cnpem-emi/qds-cv-hw/README.md

# QDS-CV Hardware
Quench detection system for vertical cryostat.
