cnpem-emi/qds-cv-hw/mechanical/back-panel.dxf

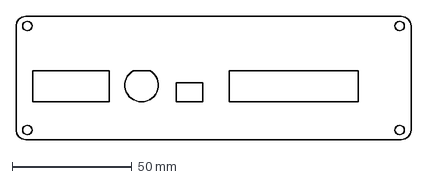
[picture p1: CAD file, 2023-08-09]
mechanical/back-panel.dxf
165.0 x 51.5 mm
