cnpem-emi/qds-cv-hw/pcb/cad/3dmodels/HAMMOND-1455T2202-body.stp

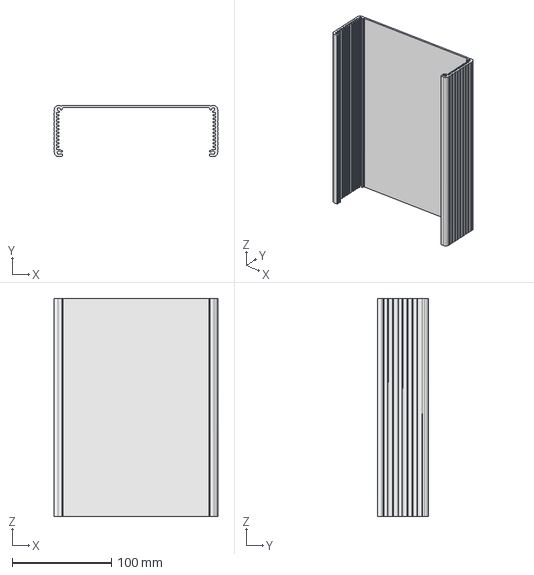
[picture p2: CAD file, 2023-05-24]
pcb/cad/3dmodels/HAMMOND-1455T2202-body.stp
165.0 x 51.5 x 220.0 mm
