cnpem-emi/qds-cv-hw/mechanical/front-panel.dxf

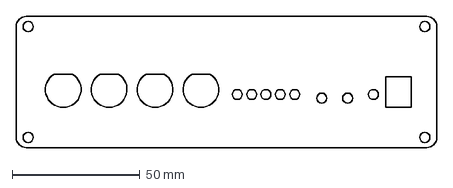
[picture p3: CAD file, 2023-08-09]
mechanical/front-panel.dxf
165.0 x 51.5 mm
