cnpem-emi/qds-cv-hw/pcb/cad/3dmodels/HAMMOND-1455T2202.stp

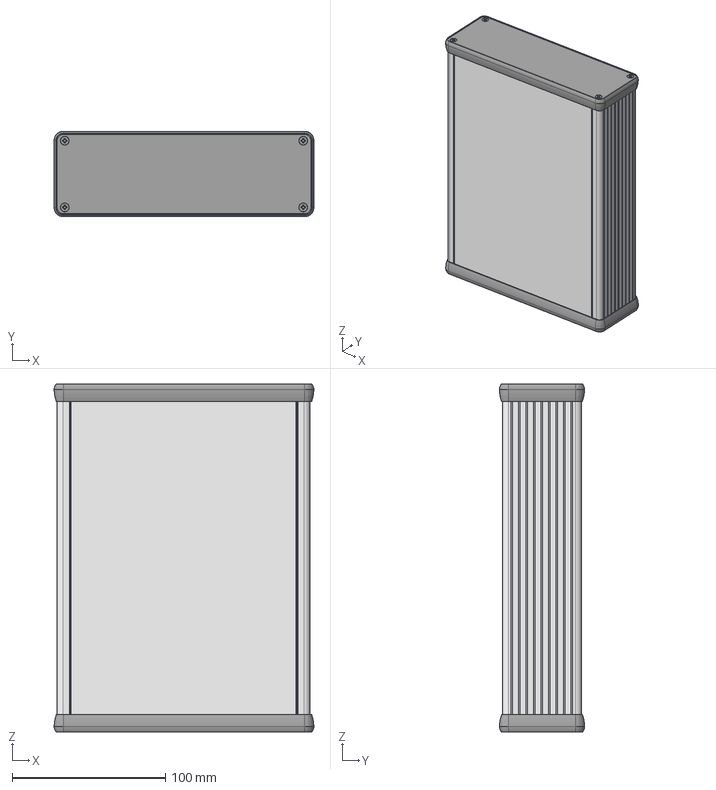
[picture p4: CAD file, 2023-05-24]
pcb/cad/3dmodels/HAMMOND-1455T2202.stp
169.5 x 55.7 x 227.0 mm
T extrusion 220mm
T Extrusion Cap 220mm
1455 Black Screw x 8
T Bezel closed x 2
