cnpem-emi/qds-cv-hw/pcb/cad/3dmodels/HAMMOND-1455T2202-top-plate.stp

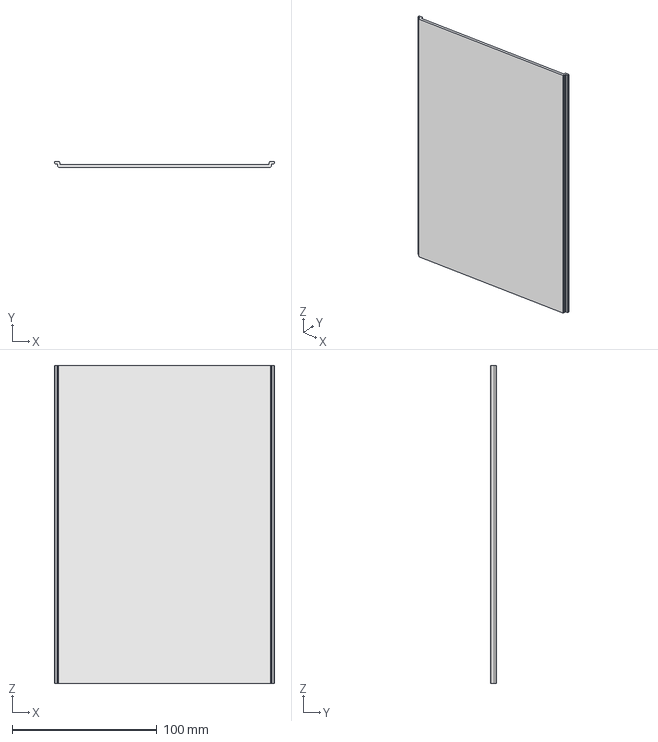
[picture p5: CAD file, 2023-05-24]
pcb/cad/3dmodels/HAMMOND-1455T2202-top-plate.stp
152.4 x 4.29 x 220.0 mm
