cnpem-emi/qds-cv-hw/pcb/cad/3dmodels/HAMMOND-1455T2202-end-panel.stp

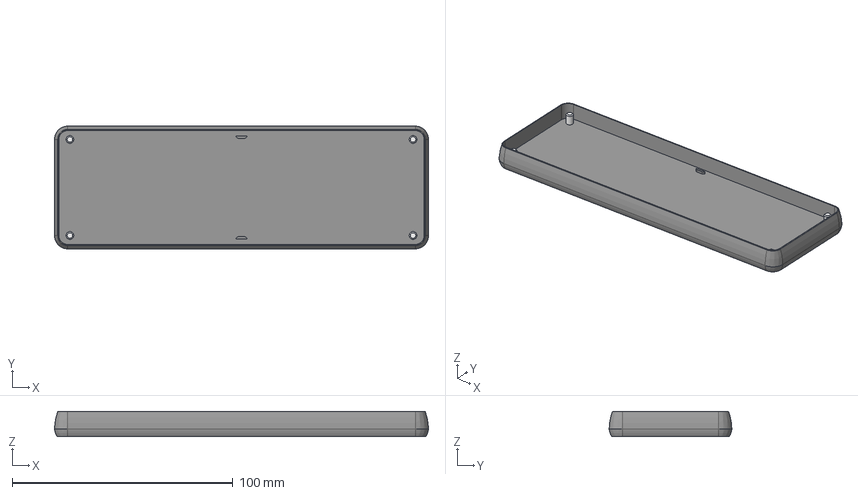
[picture p6: CAD file, 2023-05-24]
pcb/cad/3dmodels/HAMMOND-1455T2202-end-panel.stp
169.5 x 55.6 x 11.5 mm
_455T2202002
_455T2202003
_455T2202004
_455T2202005
_455T2202010
