cnpem-emi/qds-cv-hw/pcb/cad/3dmodels/D_SMA.step

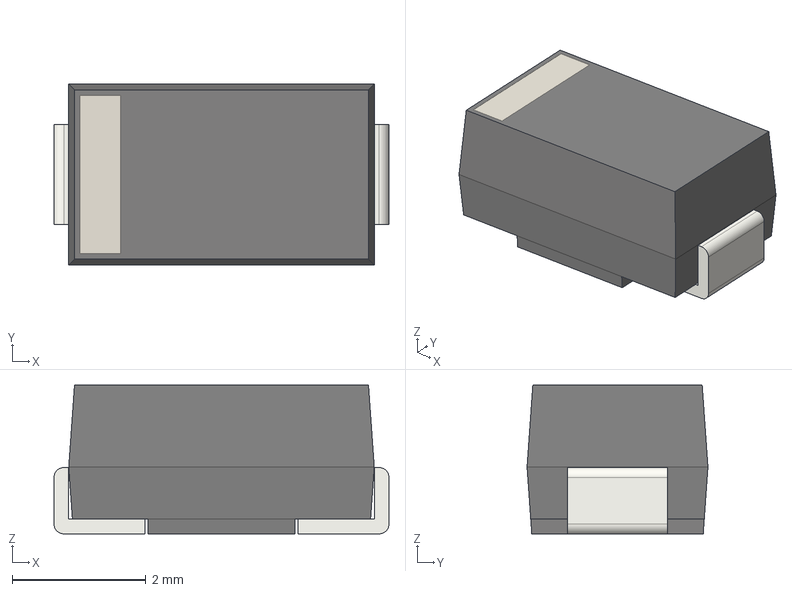
[picture p7: CAD file, 2023-05-23]
pcb/cad/3dmodels/D_SMA.step
5.00 x 2.70 x 2.22 mm
