cnpem-emi/qds-cv-hw/pcb/cad/3dmodels/D_SOD-323.step

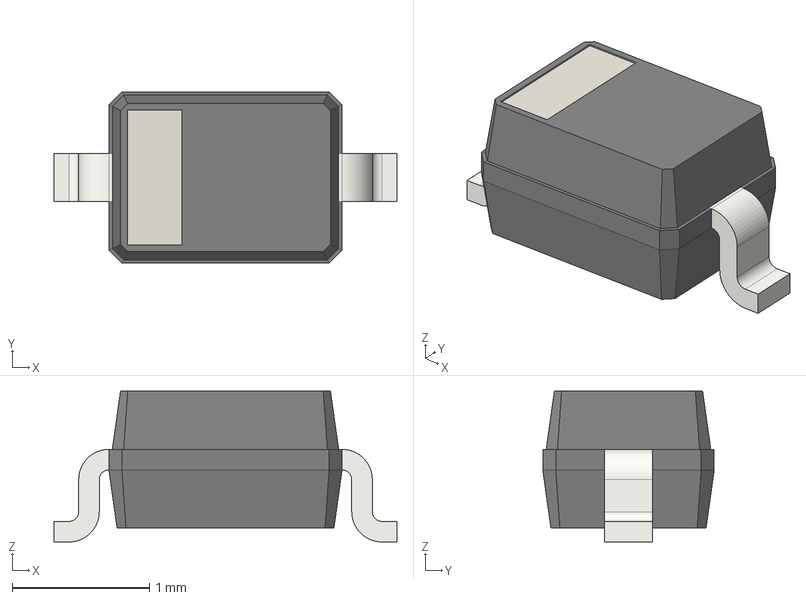
[picture p8: CAD file, 2023-05-23]
pcb/cad/3dmodels/D_SOD-323.step
2.50 x 1.25 x 1.10 mm
