cnpem-emi/qds-cv-hw/pcb/cad/3dmodels/Relay_DPDT_Finder_30.22.step

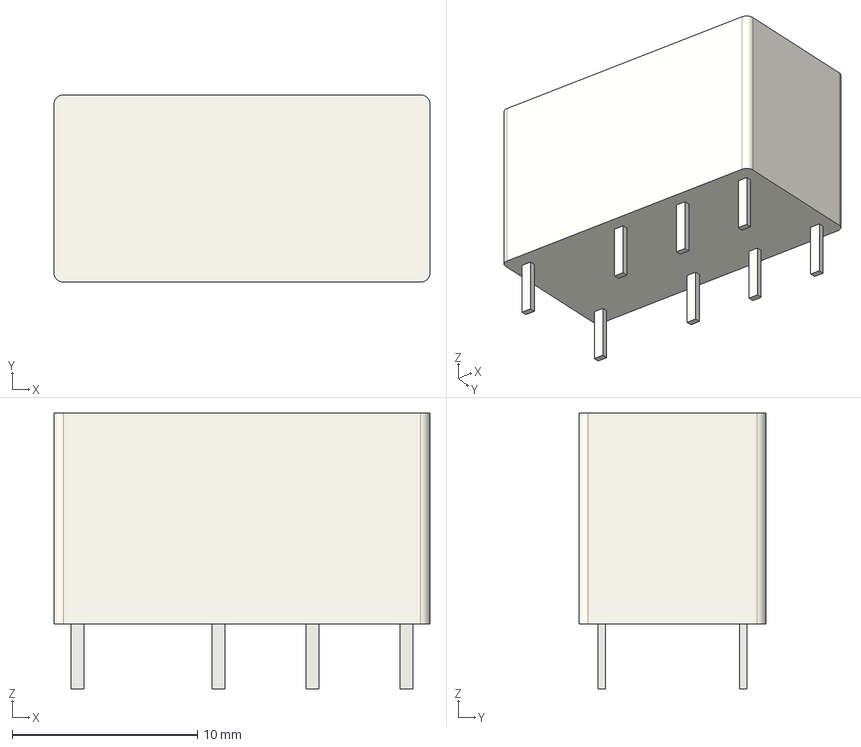
[picture p9: CAD file, 2023-05-23]
pcb/cad/3dmodels/Relay_DPDT_Finder_30.22.step
20.3 x 10.1 x 14.9 mm
