cnpem-emi/qds-cv-hw/pcb/cad/3dmodels/Converter_DCDC_RECOM_R-78E-0.5_THT.step

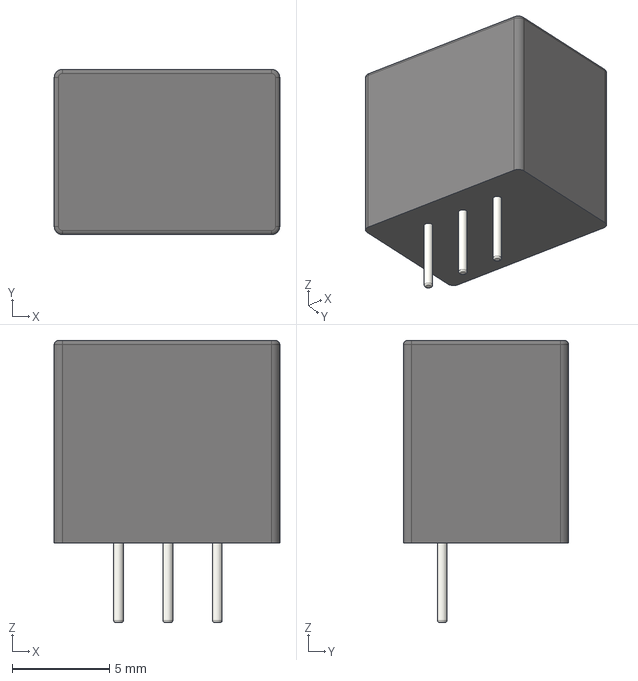
[picture p11: CAD file, 2023-05-23]
pcb/cad/3dmodels/Converter_DCDC_RECOM_R-78E-0.5_THT.step
11.6 x 8.50 x 14.5 mm
