cnpem-emi/qds-cv-hw/pcb/cad/3dmodels/SOT-23-6.step

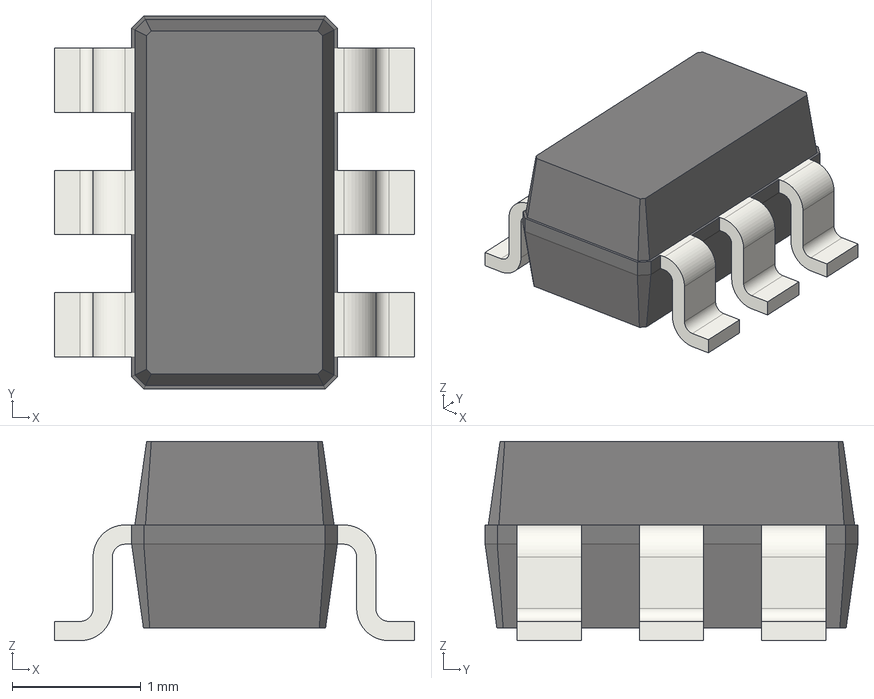
[picture p12: CAD file, 2023-05-23]
pcb/cad/3dmodels/SOT-23-6.step
2.80 x 2.90 x 1.55 mm
