cnpem-emi/qds-cv-hw/pcb/cad/3dmodels/C_Elec_6.3x7.7.step

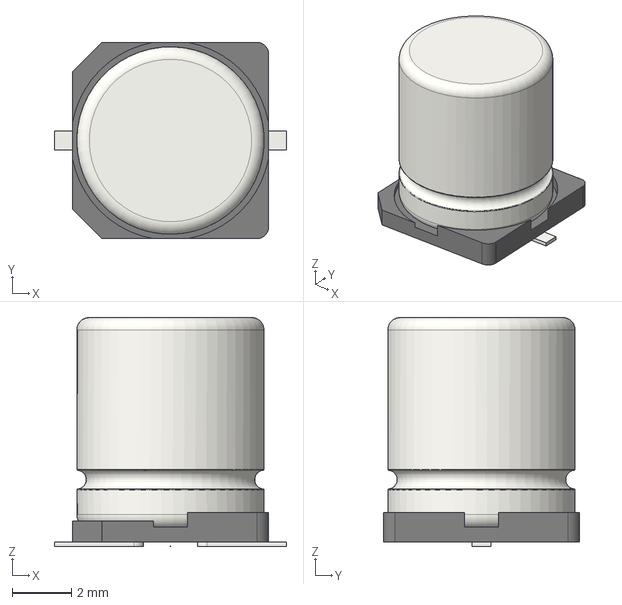
[picture p13: CAD file, 2023-05-23]
pcb/cad/3dmodels/C_Elec_6.3x7.7.step
7.80 x 6.60 x 7.70 mm
