cnpem-emi/qds-cv-hw/pcb/cad/3dmodels/CP_EIA-3528-21_Kemet-B.step

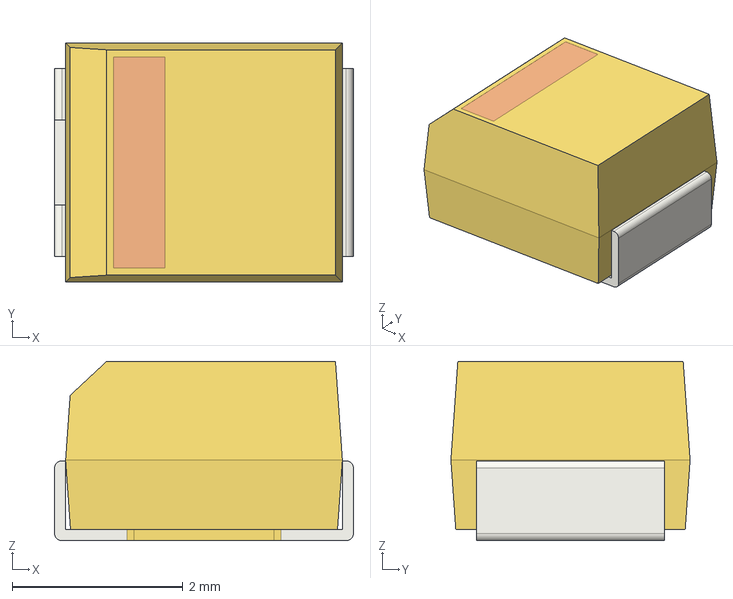
[picture p14: CAD file, 2023-05-23]
pcb/cad/3dmodels/CP_EIA-3528-21_Kemet-B.step
3.50 x 2.80 x 2.10 mm
