cnpem-emi/qds-cv-hw/pcb/cad/3dmodels/C_1206_3216Metric.step

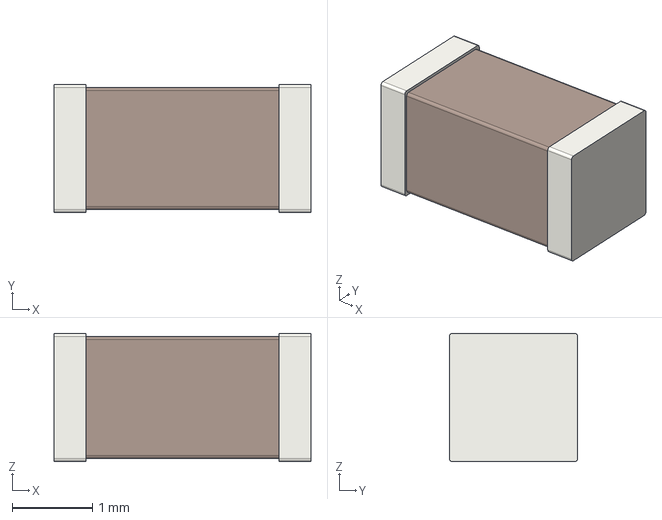
[picture p15: CAD file, 2023-05-23]
pcb/cad/3dmodels/C_1206_3216Metric.step
3.20 x 1.60 x 1.60 mm
