cnpem-emi/qds-cv-hw/pcb/cad/3dmodels/SO-14_3.9x8.65mm_P1.27mm.step

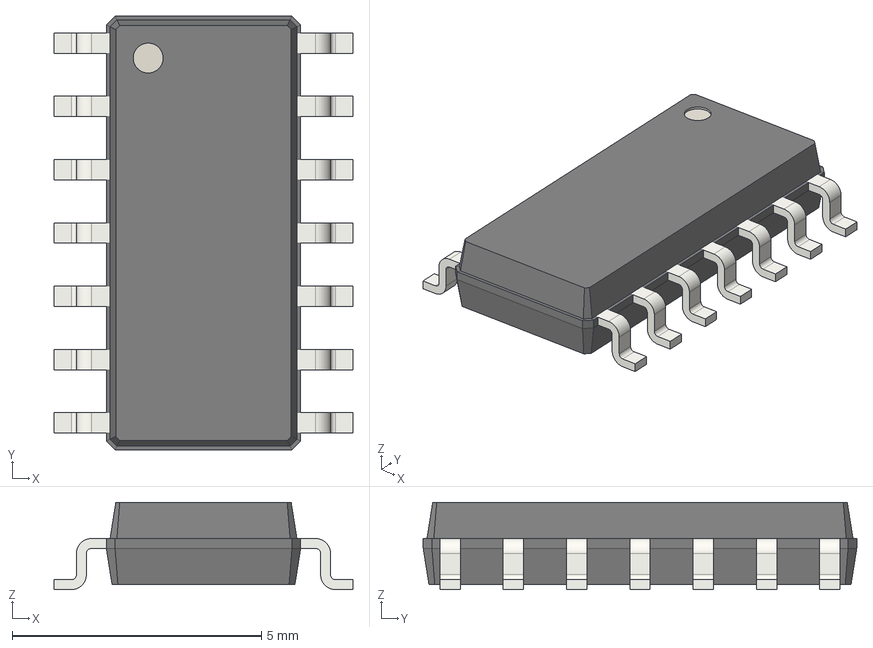
[picture p16: CAD file, 2023-05-23]
pcb/cad/3dmodels/SO-14_3.9x8.65mm_P1.27mm.step
6.00 x 8.70 x 1.75 mm
