cnpem-emi/qds-cv-hw/pcb/cad/3dmodels/SOT-223.step

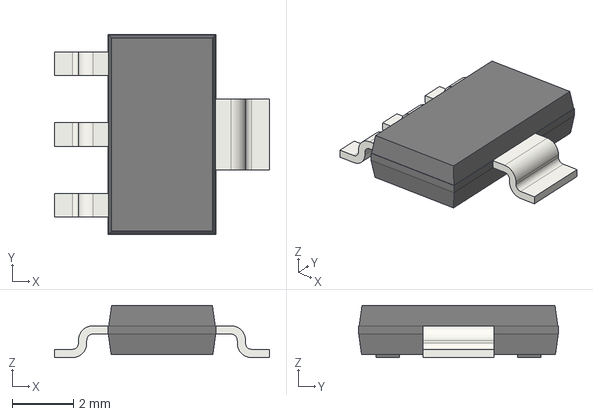
[picture p17: CAD file, 2023-05-23]
pcb/cad/3dmodels/SOT-223.step
7.00 x 6.50 x 1.70 mm
