cnpem-emi/qds-cv-hw/pcb/cad/3dmodels/R_0805_2012Metric.step

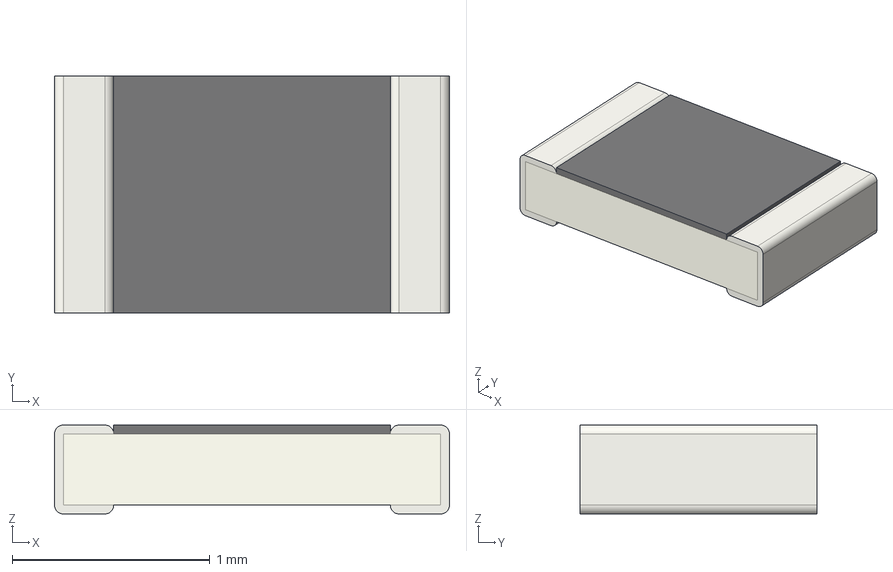
[picture p18: CAD file, 2023-05-23]
pcb/cad/3dmodels/R_0805_2012Metric.step
2.00 x 1.20 x 0.45 mm
