cnpem-emi/qds-cv-hw/pcb/cad/3dmodels/SW_DIP_SPSTx01_Slide_9.78x4.72mm_W7.62mm_P2.54mm.step

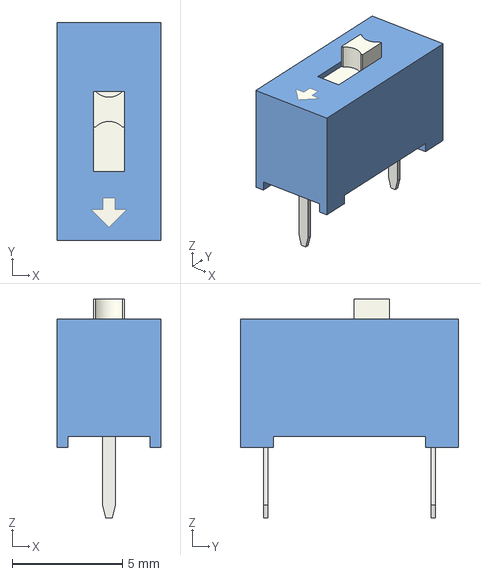
[picture p20: CAD file, 2023-05-23]
pcb/cad/3dmodels/SW_DIP_SPSTx01_Slide_9.78x4.72mm_W7.62mm_P2.54mm.step
4.72 x 9.90 x 9.95 mm
