cnpem-emi/qds-cv-hw/pcb/cad/3dmodels/C_0805_2012Metric.step

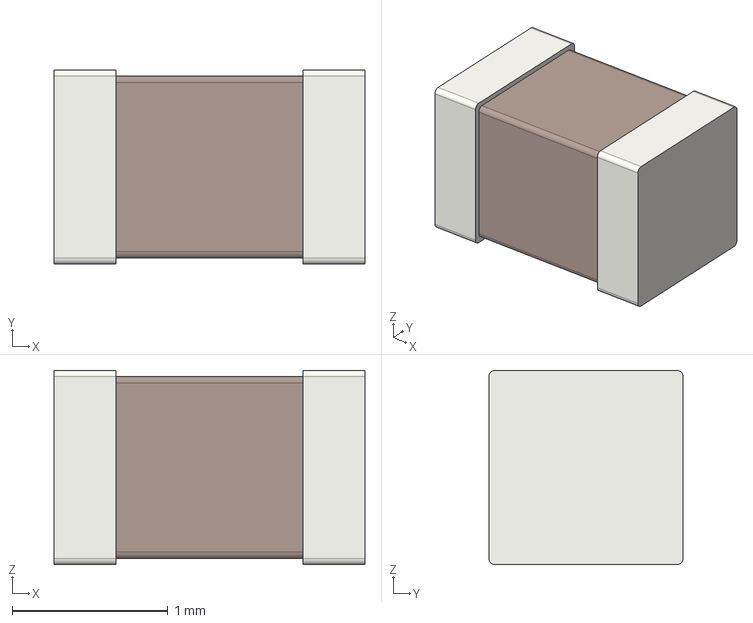
[picture p21: CAD file, 2023-05-23]
pcb/cad/3dmodels/C_0805_2012Metric.step
2.00 x 1.25 x 1.25 mm
