cnpem-emi/qds-cv-hw/pcb/cad/3dmodels/C_0603_1608Metric.step

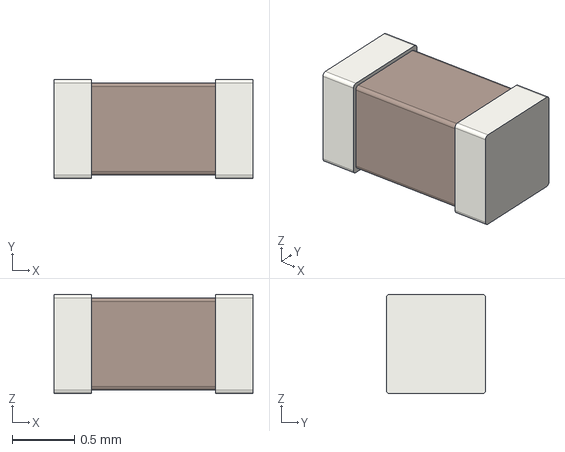
[picture p22: CAD file, 2023-05-23]
pcb/cad/3dmodels/C_0603_1608Metric.step
1.60 x 0.8 x 0.8 mm
