cnpem-emi/qds-cv-hw/pcb/cad/3dmodels/SO-20_12.8x7.5mm_P1.27mm.step

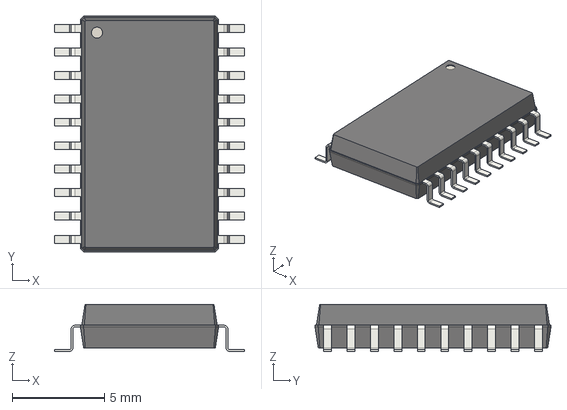
[picture p23: CAD file, 2023-05-23]
pcb/cad/3dmodels/SO-20_12.8x7.5mm_P1.27mm.step
10.3 x 12.8 x 2.55 mm
