cnpem-emi/qds-cv-hw/pcb/cad/3dmodels/SOIC-16_3.9x9.9mm_P1.27mm.step

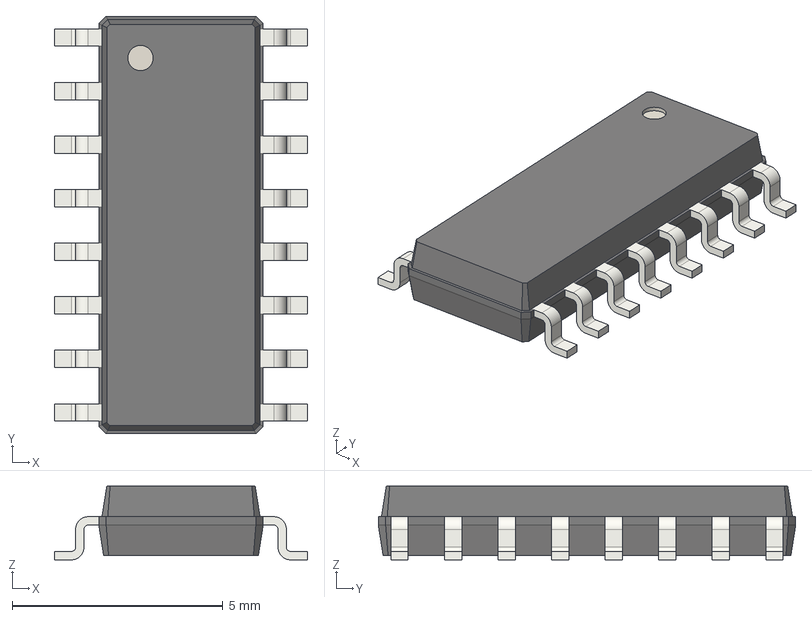
[picture p24: CAD file, 2023-05-23]
pcb/cad/3dmodels/SOIC-16_3.9x9.9mm_P1.27mm.step
6.00 x 9.90 x 1.75 mm
