cnpem-emi/qds-cv-hw/pcb/cad/3dmodels/SW_DIP_SPSTx04_Slide_6.7x11.72mm_W8.61mm_P2.54mm_LowProfile.step

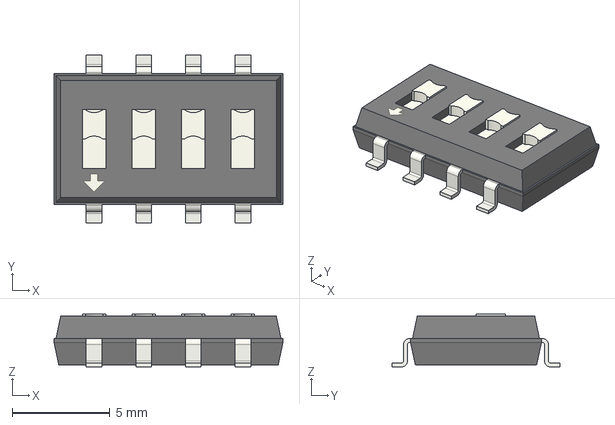
[picture p25: CAD file, 2023-05-23]
pcb/cad/3dmodels/SW_DIP_SPSTx04_Slide_6.7x11.72mm_W8.61mm_P2.54mm_LowProfile.step
11.7 x 8.61 x 2.70 mm
