cnpem-emi/qds-cv-hw/pcb/cad/3dmodels/SOIC-8_3.9x4.9mm_P1.27mm.step

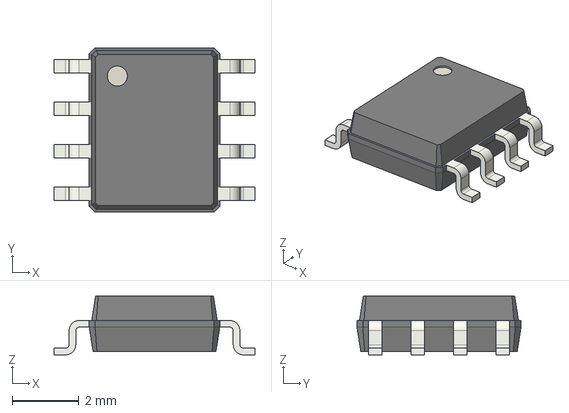
[picture p26: CAD file, 2023-05-23]
pcb/cad/3dmodels/SOIC-8_3.9x4.9mm_P1.27mm.step
6.00 x 4.90 x 1.75 mm
