cnpem-emi/qds-cv-hw/pcb/cad/3dmodels/SOT-23.step

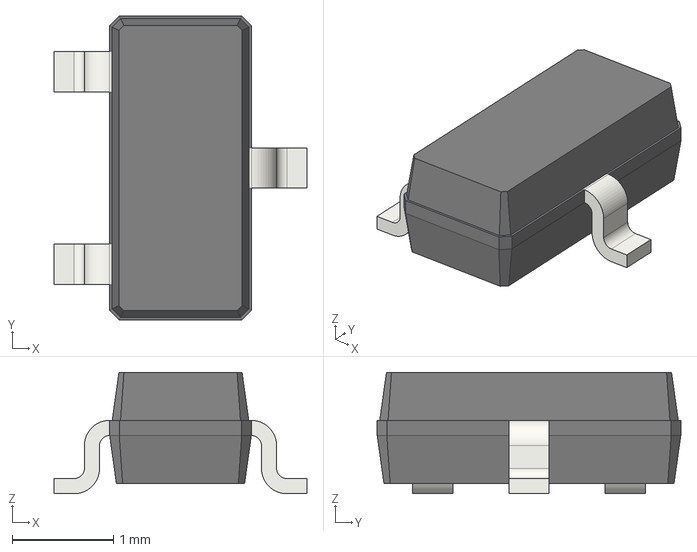
[picture p27: CAD file, 2023-05-23]
pcb/cad/3dmodels/SOT-23.step
2.50 x 3.00 x 1.20 mm
