cnpem-emi/qds-cv-hw/pcb/cad/3dmodels/C_1812_4532Metric.step

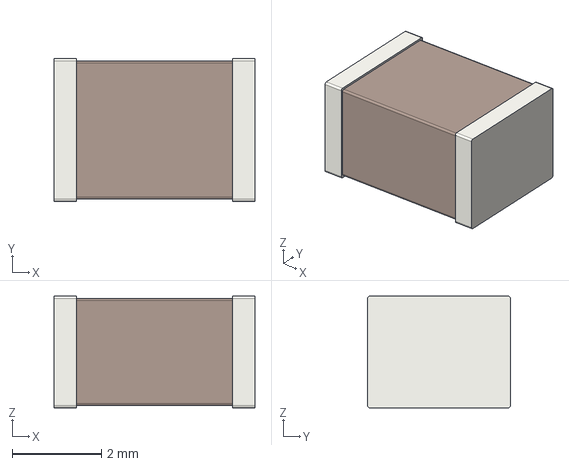
[picture p28: CAD file, 2023-05-23]
pcb/cad/3dmodels/C_1812_4532Metric.step
4.50 x 3.20 x 2.50 mm
