cnpem-emi/qds-cv-hw/pcb/cad/3dmodels/DUB0008A.stp

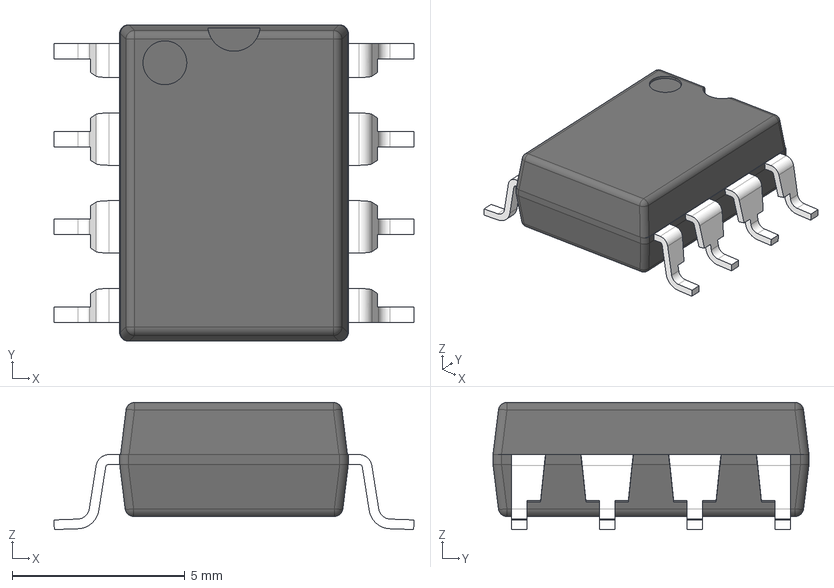
[picture p29: CAD file, 2023-05-23]
pcb/cad/3dmodels/DUB0008A.stp
10.4 x 9.15 x 3.68 mm
BODY-SO_AF0
LEAD-SO_AF1
LEAD-SO x 4
LEAD-SO_AF0
LEAD-SO_AF3
LEAD-SO_AF2
