cnpem-emi/qds-cv-hw/pcb/cad/3dmodels/CP_EIA-6032-28_Kemet-C.step

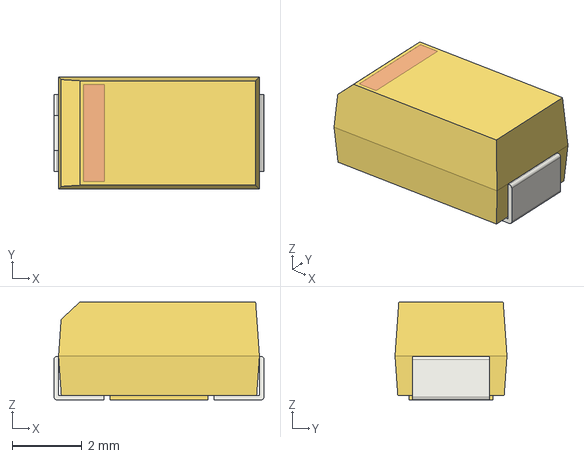
[picture p30: CAD file, 2023-05-23]
pcb/cad/3dmodels/CP_EIA-6032-28_Kemet-C.step
6.00 x 3.20 x 2.80 mm
