cnpem-emi/qds-cv-hw/pcb/cad/3dmodels/SW_Tactile_SPST_Angled_PTS645Vx39-2LFS.step

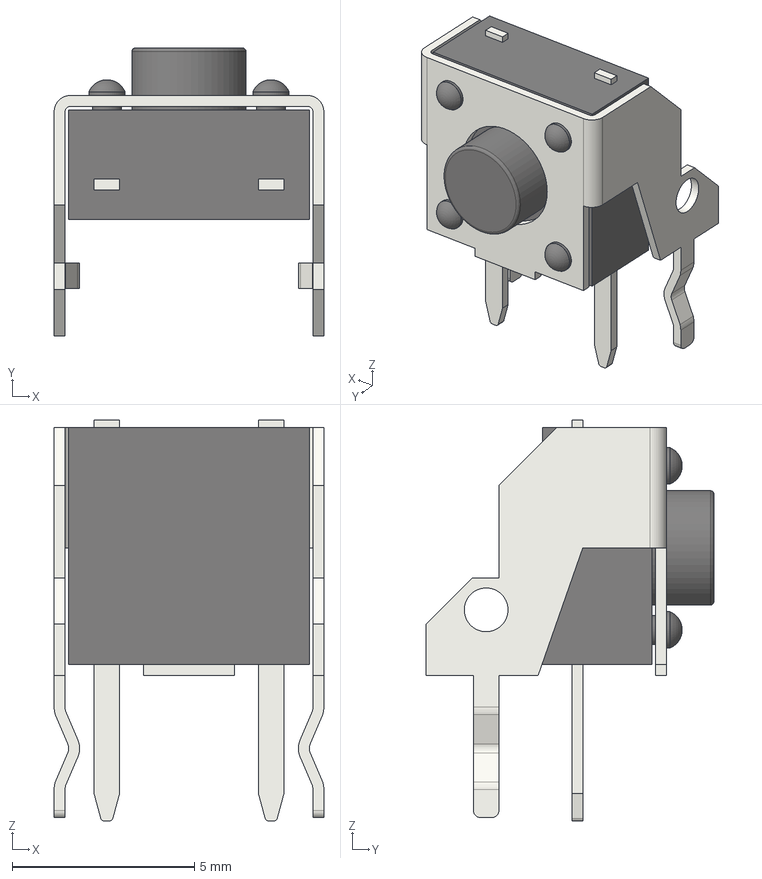
[picture p31: CAD file, 2023-05-23]
pcb/cad/3dmodels/SW_Tactile_SPST_Angled_PTS645Vx39-2LFS.step
7.40 x 7.90 x 11.0 mm
