cnpem-emi/qds-cv-hw/pcb/cad/3dmodels/DSUB-25_Female_Horizontal_P2.77x2.84mm_EdgePinOffset7.70mm_Housed_MountingHolesOffset9.12mm.step

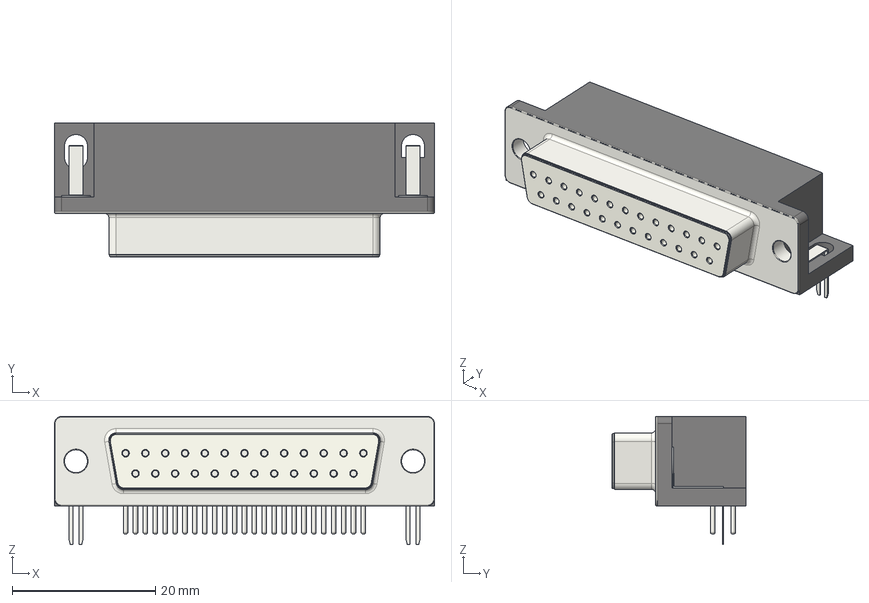
[picture p32: CAD file, 2023-05-23]
pcb/cad/3dmodels/DSUB-25_Female_Horizontal_P2.77x2.84mm_EdgePinOffset7.70mm_Housed_MountingHolesOffset9.12mm.step
53.1 x 18.7 x 17.9 mm
