cnpem-emi/qds-cv-hw/pcb/cad/3dmodels/D_SMB.step

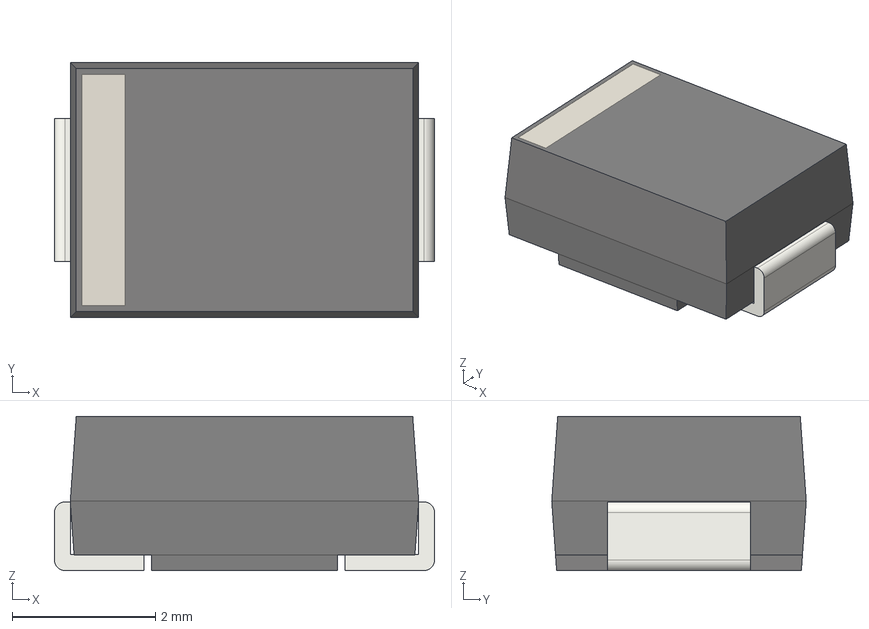
[picture p33: CAD file, 2023-05-23]
pcb/cad/3dmodels/D_SMB.step
5.30 x 3.55 x 2.15 mm
