cnpem-emi/qds-cv-hw/pcb/cad/3dmodels/SOP-8_6.62x9.15mm_P2.54mm.stp

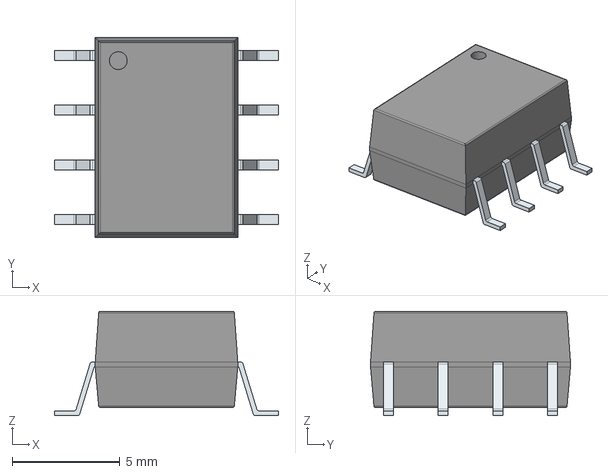
[picture p34: CAD file, 2023-05-23]
pcb/cad/3dmodels/SOP-8_6.62x9.15mm_P2.54mm.stp
10.4 x 9.29 x 4.85 mm
PinsArrayLR
