cnpem-emi/qds-cv-hw/pcb/cad/3dmodels/ZH212.step

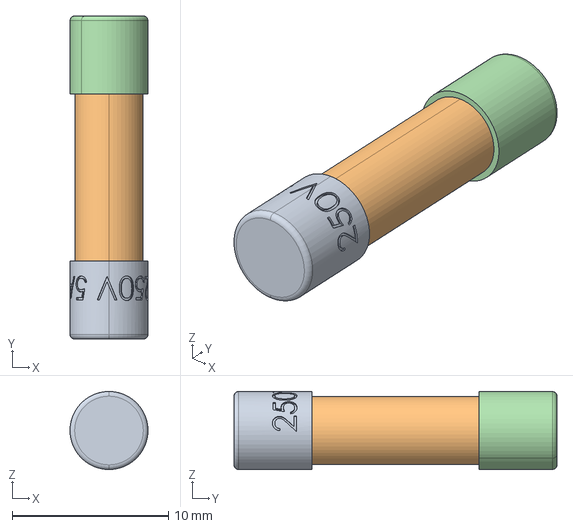
[picture p35: CAD file, 2023-05-16]
pcb/cad/3dmodels/ZH212.step
5.00 x 20.7 x 5.00 mm
