cnpem-emi/qds-cv-hw/pcb/cad/3dmodels/TEST-POINT-White-Keystone-5012.stp

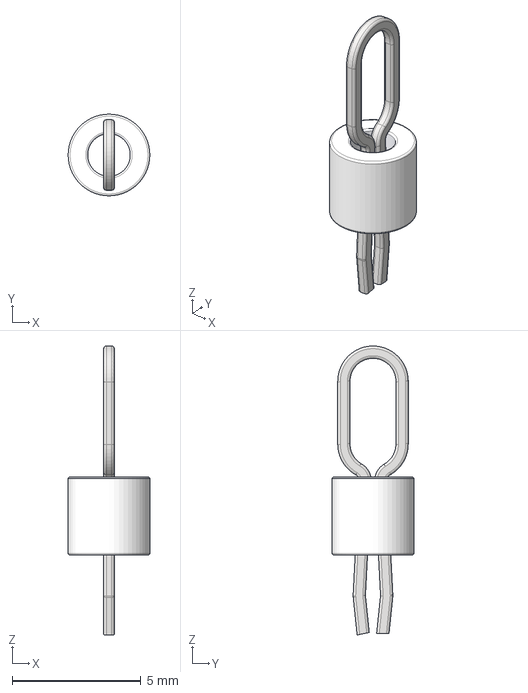
[picture p36: CAD file, 2023-05-16]
pcb/cad/3dmodels/TEST-POINT-White-Keystone-5012.stp
3.17 x 3.17 x 11.2 mm
