cnpem-emi/qds-cv-hw/pcb/cad/3dmodels/BNC5-P-C-HN-ST-CA1.stp

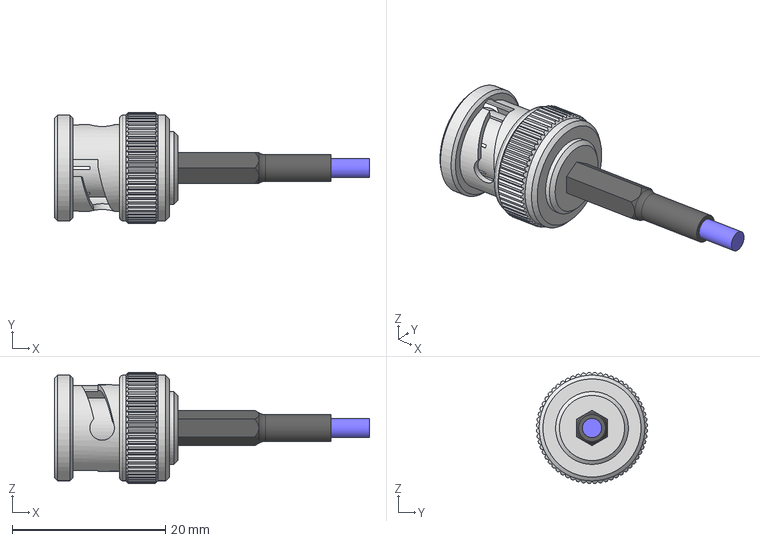
[picture p37: CAD file, 2023-05-04]
pcb/cad/3dmodels/BNC5-P-C-HN-ST-CA1.stp
41.1 x 14.5 x 14.5 mm
BNC5-P-C-XX-ST-CA1_PIN
BNC5-P-C-XX-ST-CA1_BODY
