cnpem-emi/qds-cv-hw/pcb/cad/3dmodels/DB-9-s8655mh0901bxx.STP

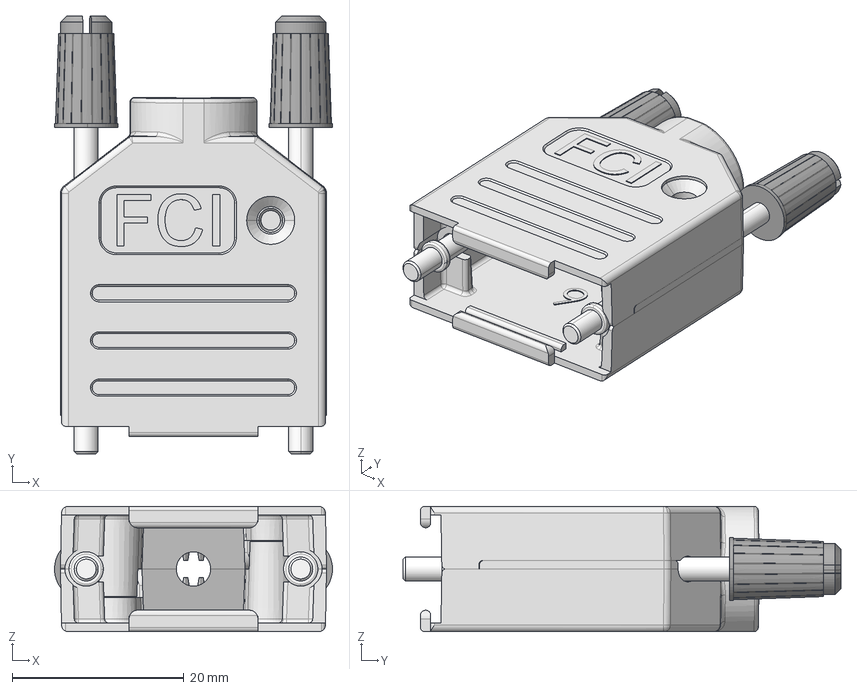
[picture p38: CAD file, 2023-05-04]
pcb/cad/3dmodels/DB-9-s8655mh0901bxx.STP
32.4 x 51.0 x 14.6 mm
DTZK9-FCI-D5 x 2
MFX-M3X10_MFX x 2
4_ED5 x 2
D-JS x 2
KNOP_TIL_JACK_SCREW x 2
