cnpem-emi/qds-cv-hw/pcb/cad/3dmodels/MSOP-12_MSE.STEP

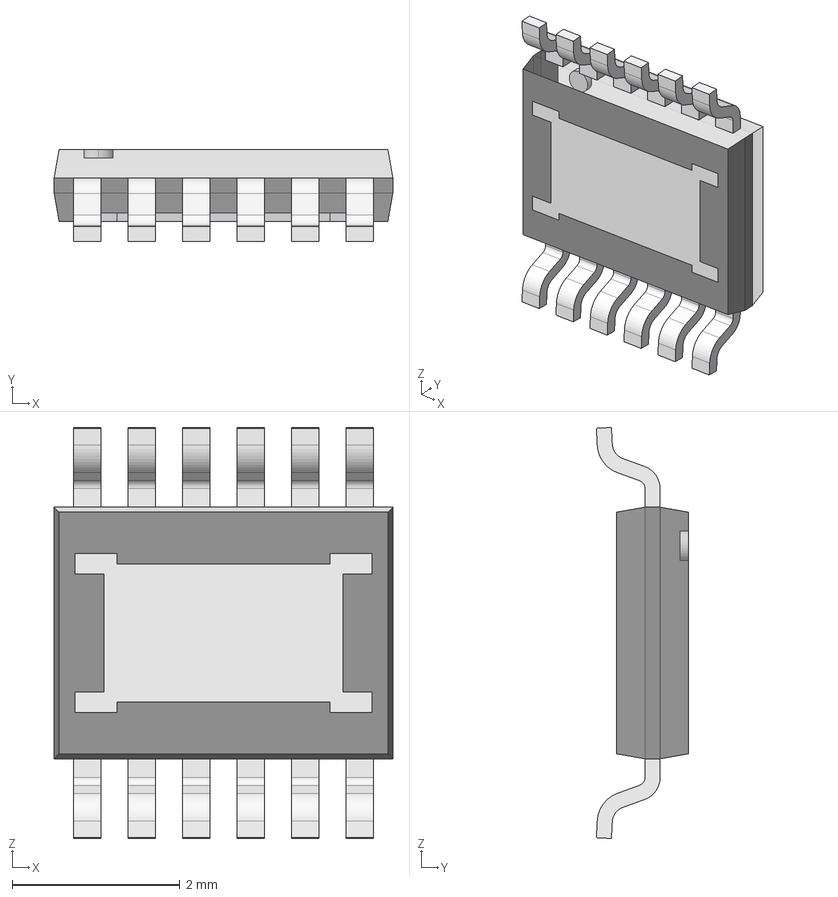
[picture p39: CAD file, 2023-04-27]
pcb/cad/3dmodels/MSOP-12_MSE.STEP
4.04 x 1.10 x 4.90 mm
