cnpem-emi/qds-cv-hw/pcb/cad/3dmodels/JCM30.STEP

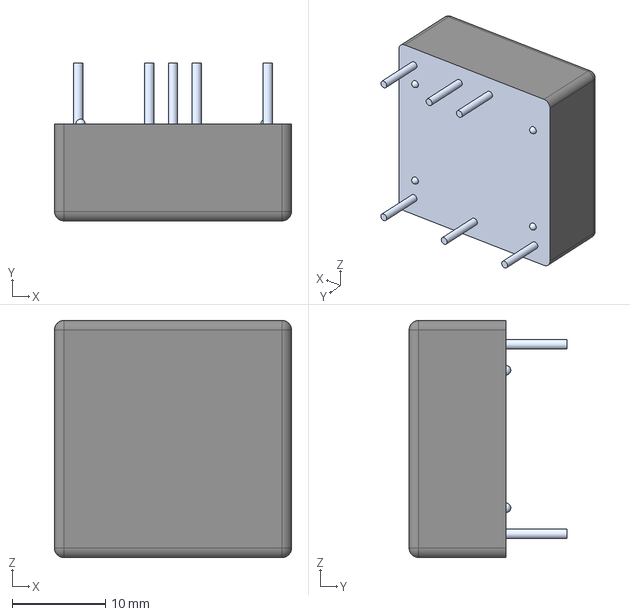
[picture p40: CAD file, 2023-04-27]
pcb/cad/3dmodels/JCM30.STEP
25.4 x 16.9 x 25.4 mm
