cnpem-emi/qds-cv-hw/pcb/cad/3dmodels/3224X.stp

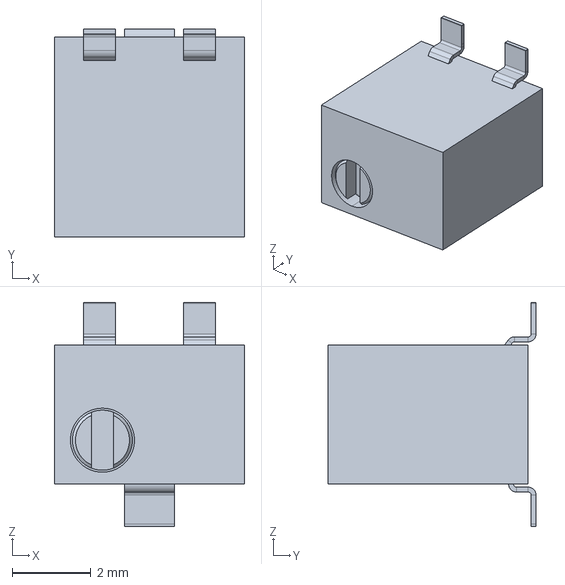
[picture p41: CAD file, 2023-04-01]
pcb/cad/3dmodels/3224X.stp
4.83 x 5.28 x 5.68 mm
