cnpem-emi/qds-cv-hw/pcb/cad/3dmodels/934CB_ID.STEP

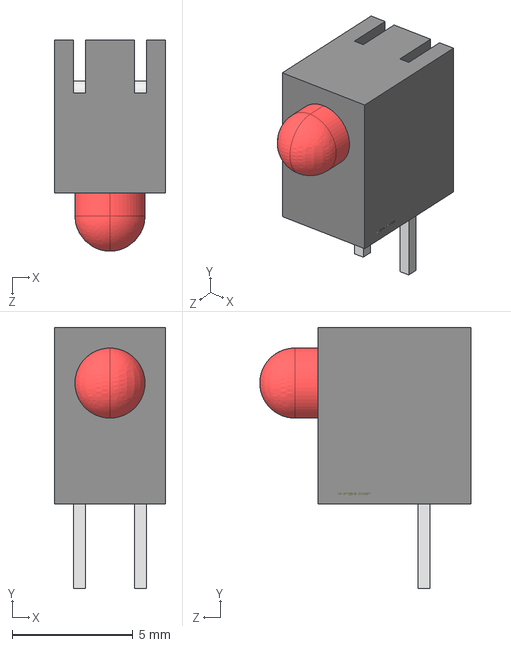
[picture p42: CAD file, 2023-03-22]
pcb/cad/3dmodels/934CB_ID.STEP
4.60 x 10.8 x 8.75 mm
