cnpem-emi/qds-cv-hw/pcb/cad/3dmodels/ZH242.STEP

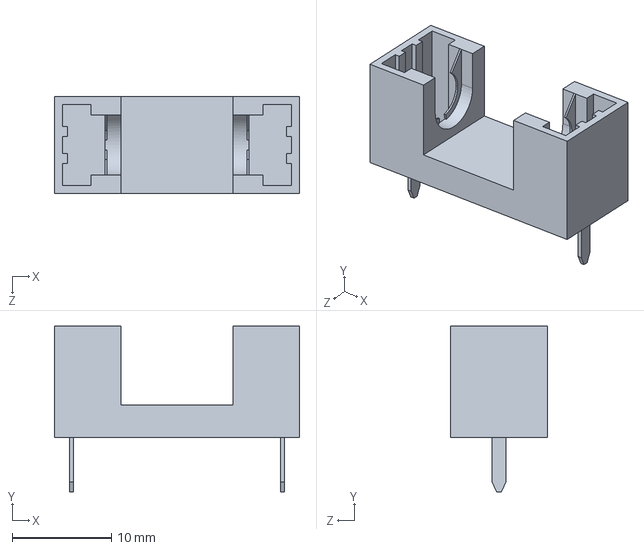
[picture p43: CAD file, 2023-03-21]
pcb/cad/3dmodels/ZH242.STEP
24.7 x 16.7 x 9.75 mm
