cnpem-emi/qds-cv-hw/pcb/cad/3dmodels/SMBJ15A.step

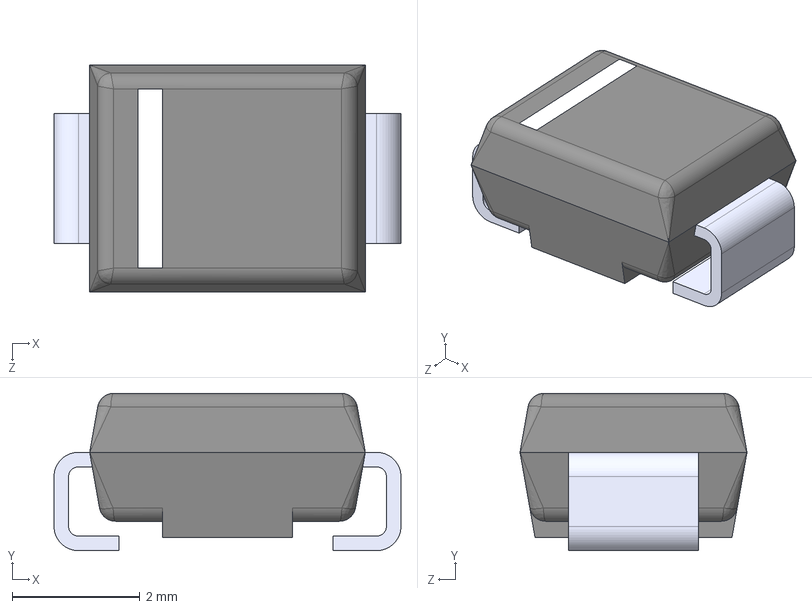
[picture p44: CAD file, 2023-03-21]
pcb/cad/3dmodels/SMBJ15A.step
5.44 x 2.46 x 3.56 mm
