cnpem-emi/qds-cv-hw/pcb/cad/3dmodels/LT1965EMS8E_PBF.step

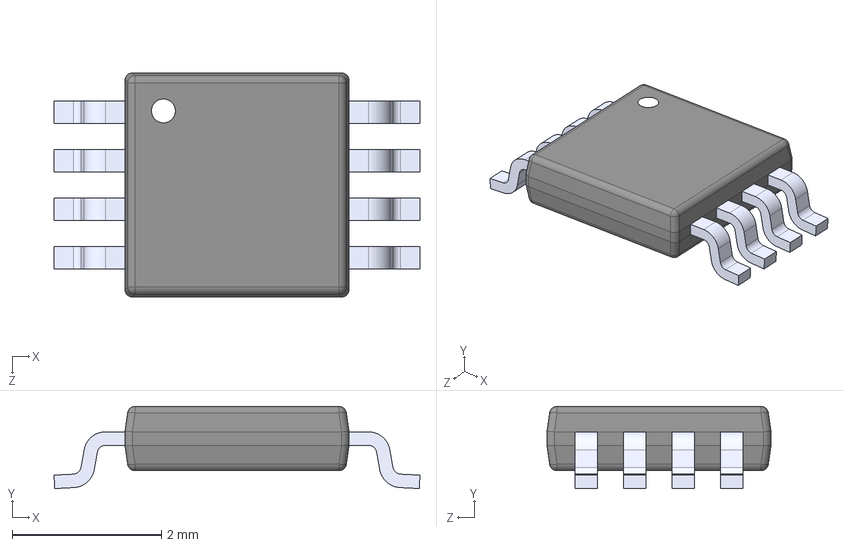
[picture p45: CAD file, 2023-03-21]
pcb/cad/3dmodels/LT1965EMS8E_PBF.step
4.90 x 1.10 x 3.00 mm
