cnpem-emi/qds-cv-hw/pcb/cad/3dmodels/CUI_DEVICES_PJ-002AH.step

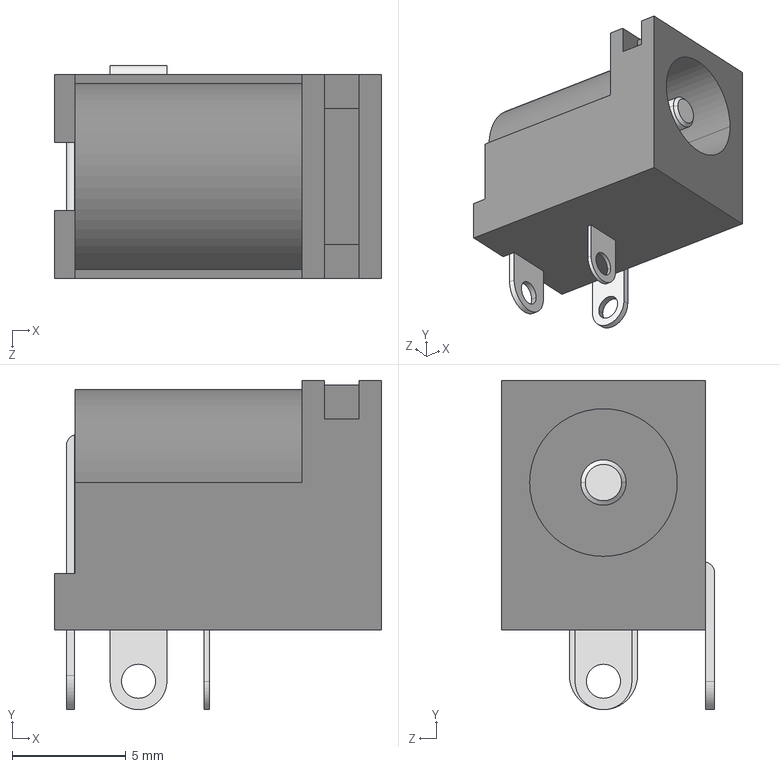
[picture p46: CAD file, 2023-03-21]
pcb/cad/3dmodels/CUI_DEVICES_PJ-002AH.step
14.4 x 14.5 x 9.40 mm
