cnpem-emi/qds-cv-hw/pcb/cad/3dmodels/ZH242-CAP.STEP

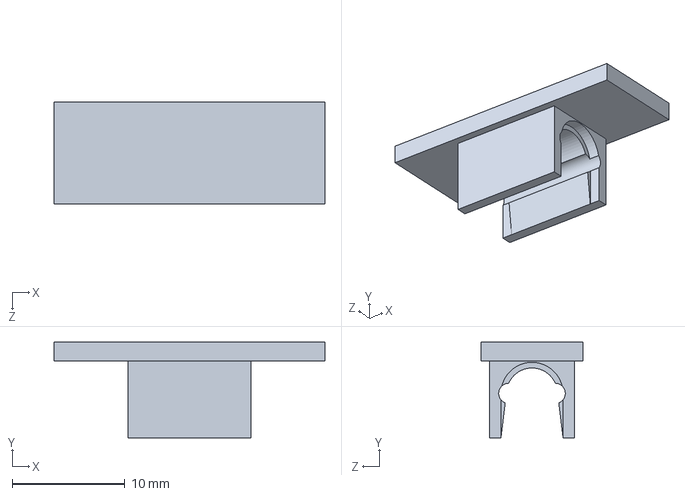
[picture p47: CAD file, 2023-03-21]
pcb/cad/3dmodels/ZH242-CAP.STEP
24.0 x 8.50 x 9.00 mm
