cnpem-emi/qds-cv-hw/pcb/cad/3dmodels/RI-1515S.step

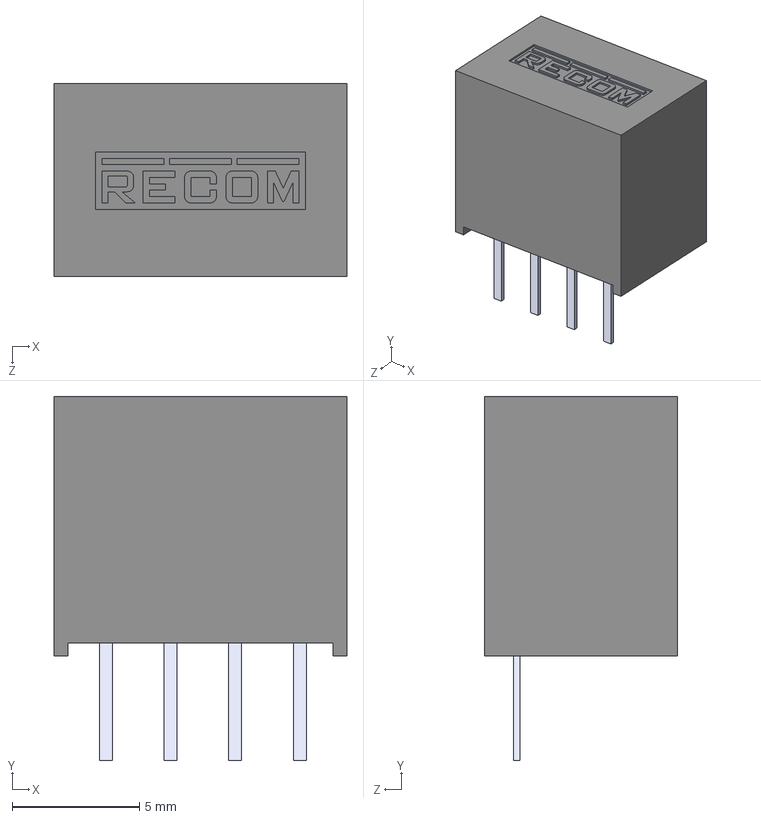
[picture p48: CAD file, 2023-03-20]
pcb/cad/3dmodels/RI-1515S.step
11.5 x 14.3 x 7.60 mm
