cnpem-emi/qds-cv-hw/pcb/cad/3dmodels/HFBR-1521Z.STEP

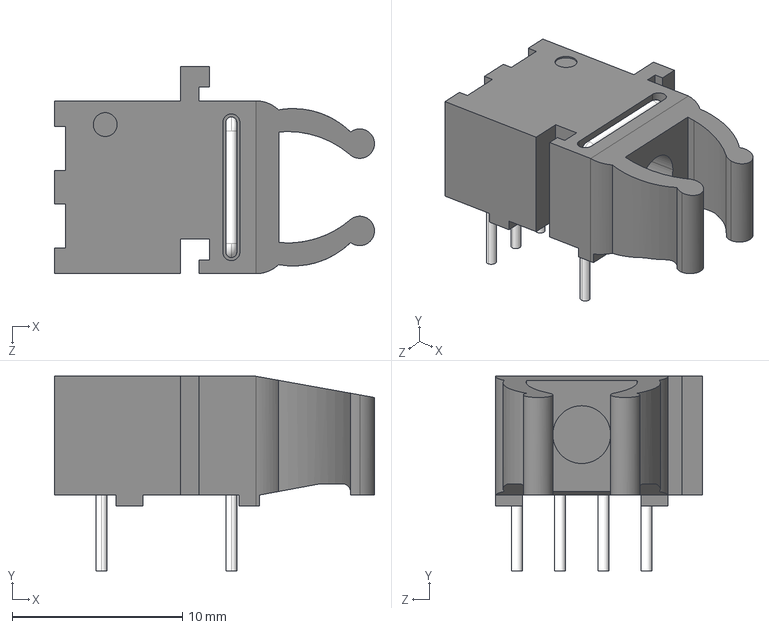
[picture p49: CAD file, 2023-03-20]
pcb/cad/3dmodels/HFBR-1521Z.STEP
18.8 x 11.4 x 12.2 mm
