cnpem-emi/qds-cv-hw/(list of files, cad)

Other CAD files:
pcb/cad/3dmodels/934CB_GD.STEP
pcb/cad/3dmodels/0731375003.STEP
