cnpem-emi/qds-cv-hw/simulation/validation-vsource-50ms.txt

0 5
+10m 5
+1u 0
+10m 0

+1u 5
+50m 5
+1u 0
+5m 0

+1u 5
+5m 5
+1u 0
+5m 0

+1u 5
+50m 5
+1u 0
+70m 0

+1u 5
