cnpem-emi/qds-cv-hw/simulation/validation-vsource-micro.txt

+1n 5
+1u 5
+1n 0
+1u 0

+1n 5
+2u 5
+1n 0
+1u 0

+1n 5
+1u 5
+1n 0
+1u 0

+1n 5
+2u 5
+1n 0
+1u 0
