cnpem-emi/qds-cv-hw/pcb/pdf/qds-cv.pdf

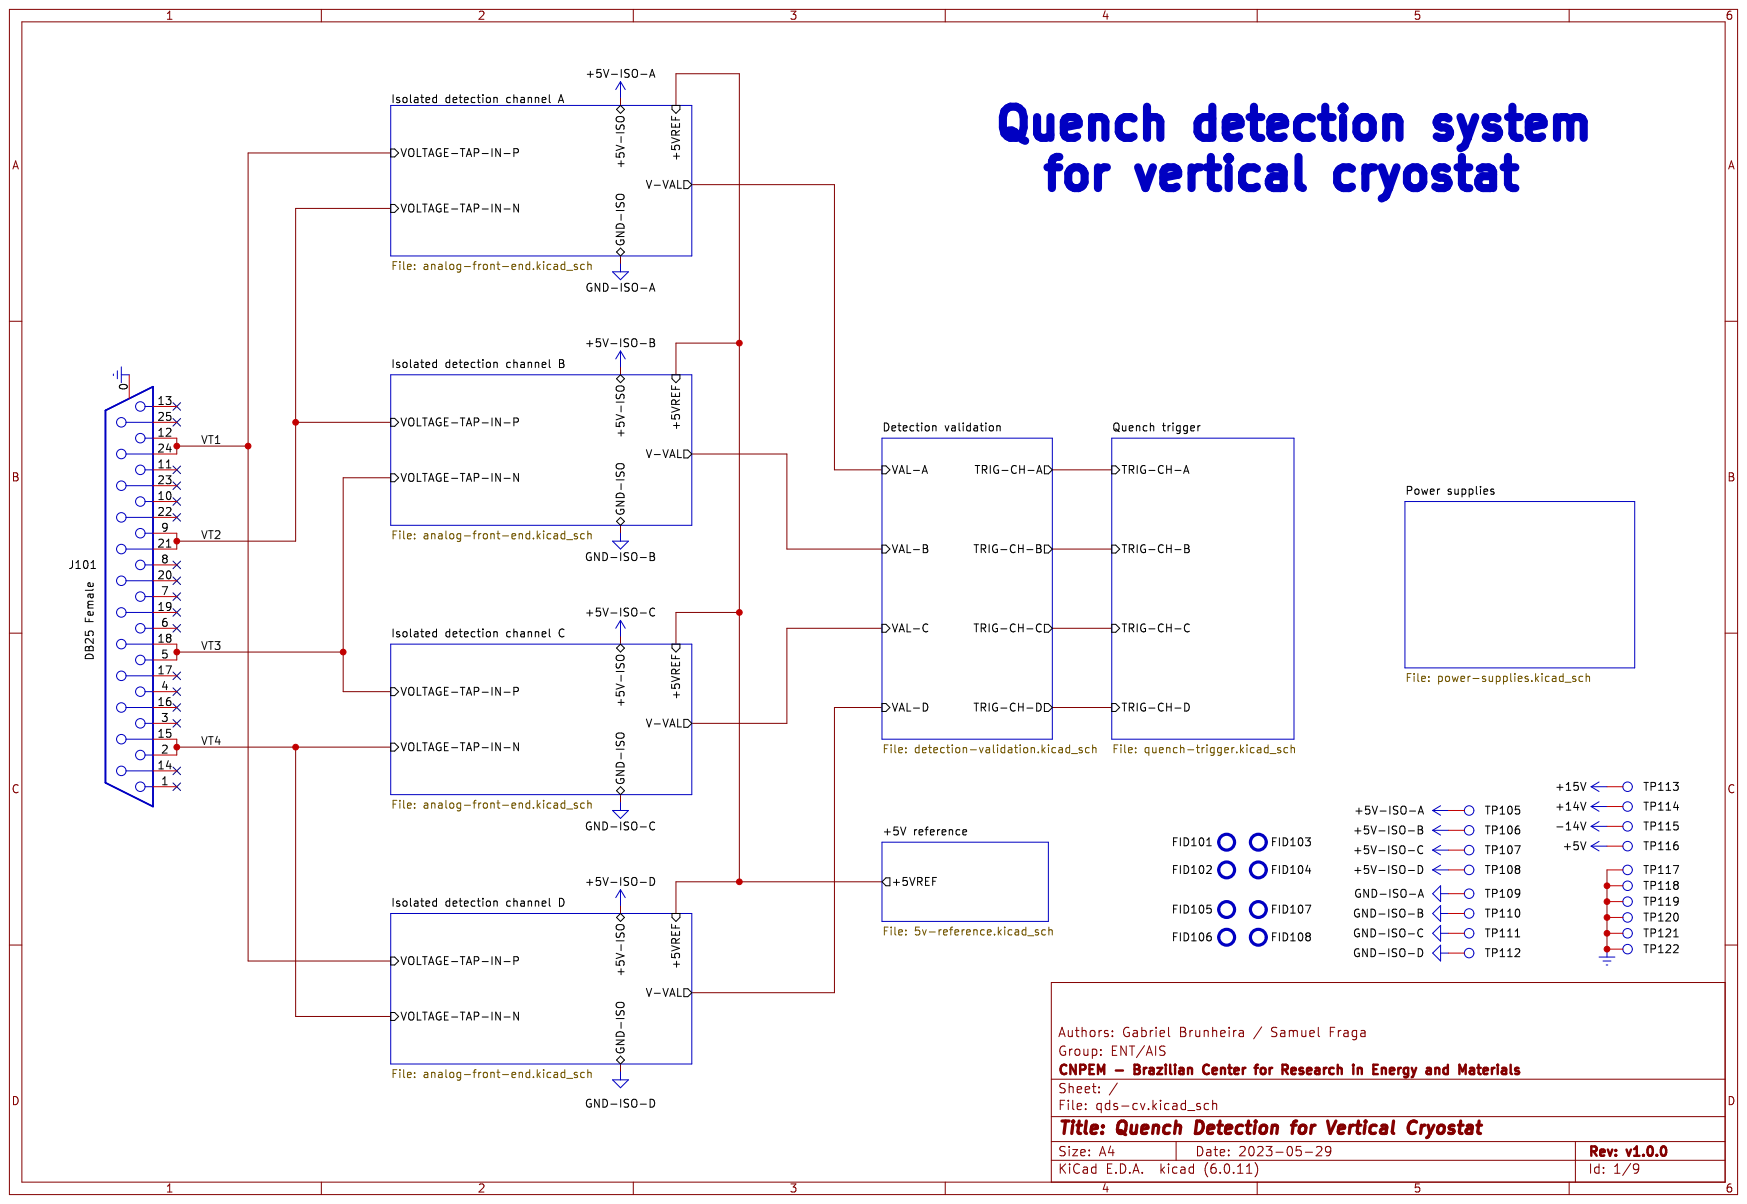
[picture p50: page 1]

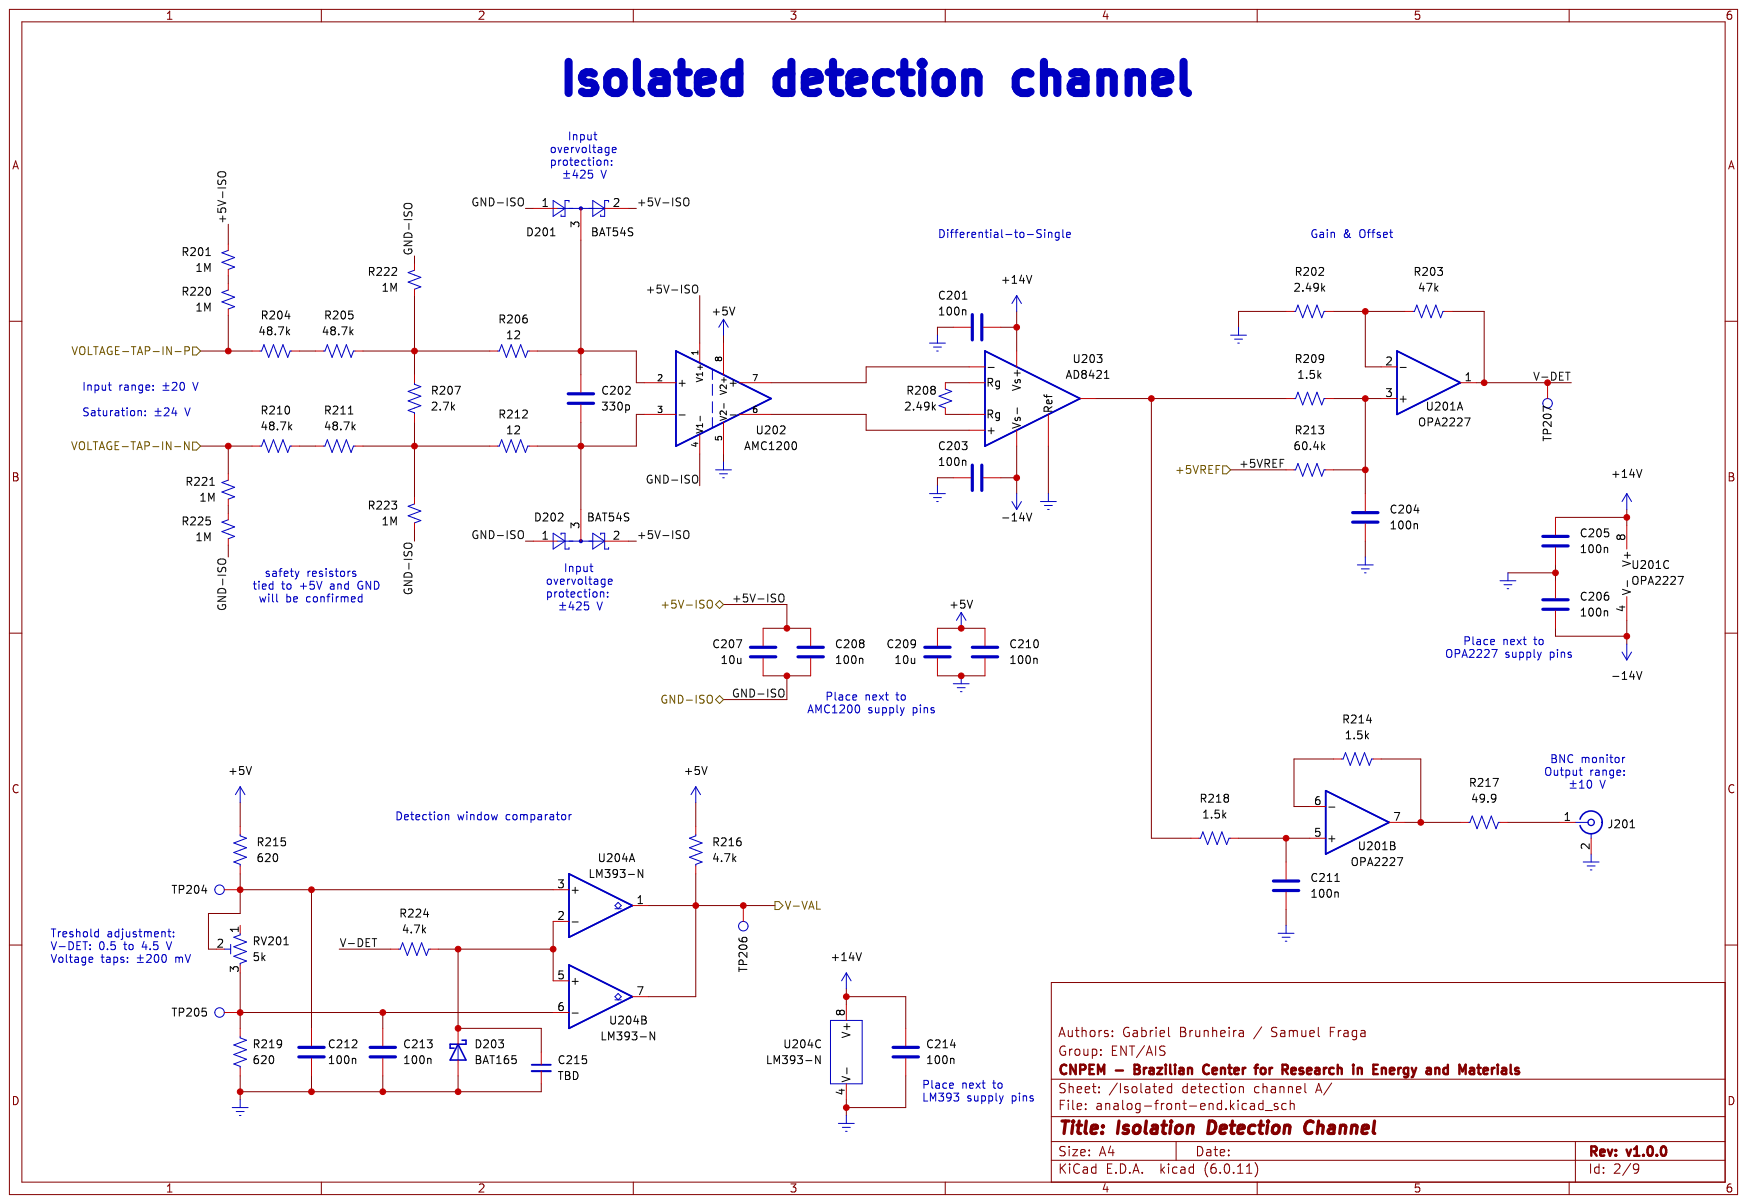
[picture p51: page 2]

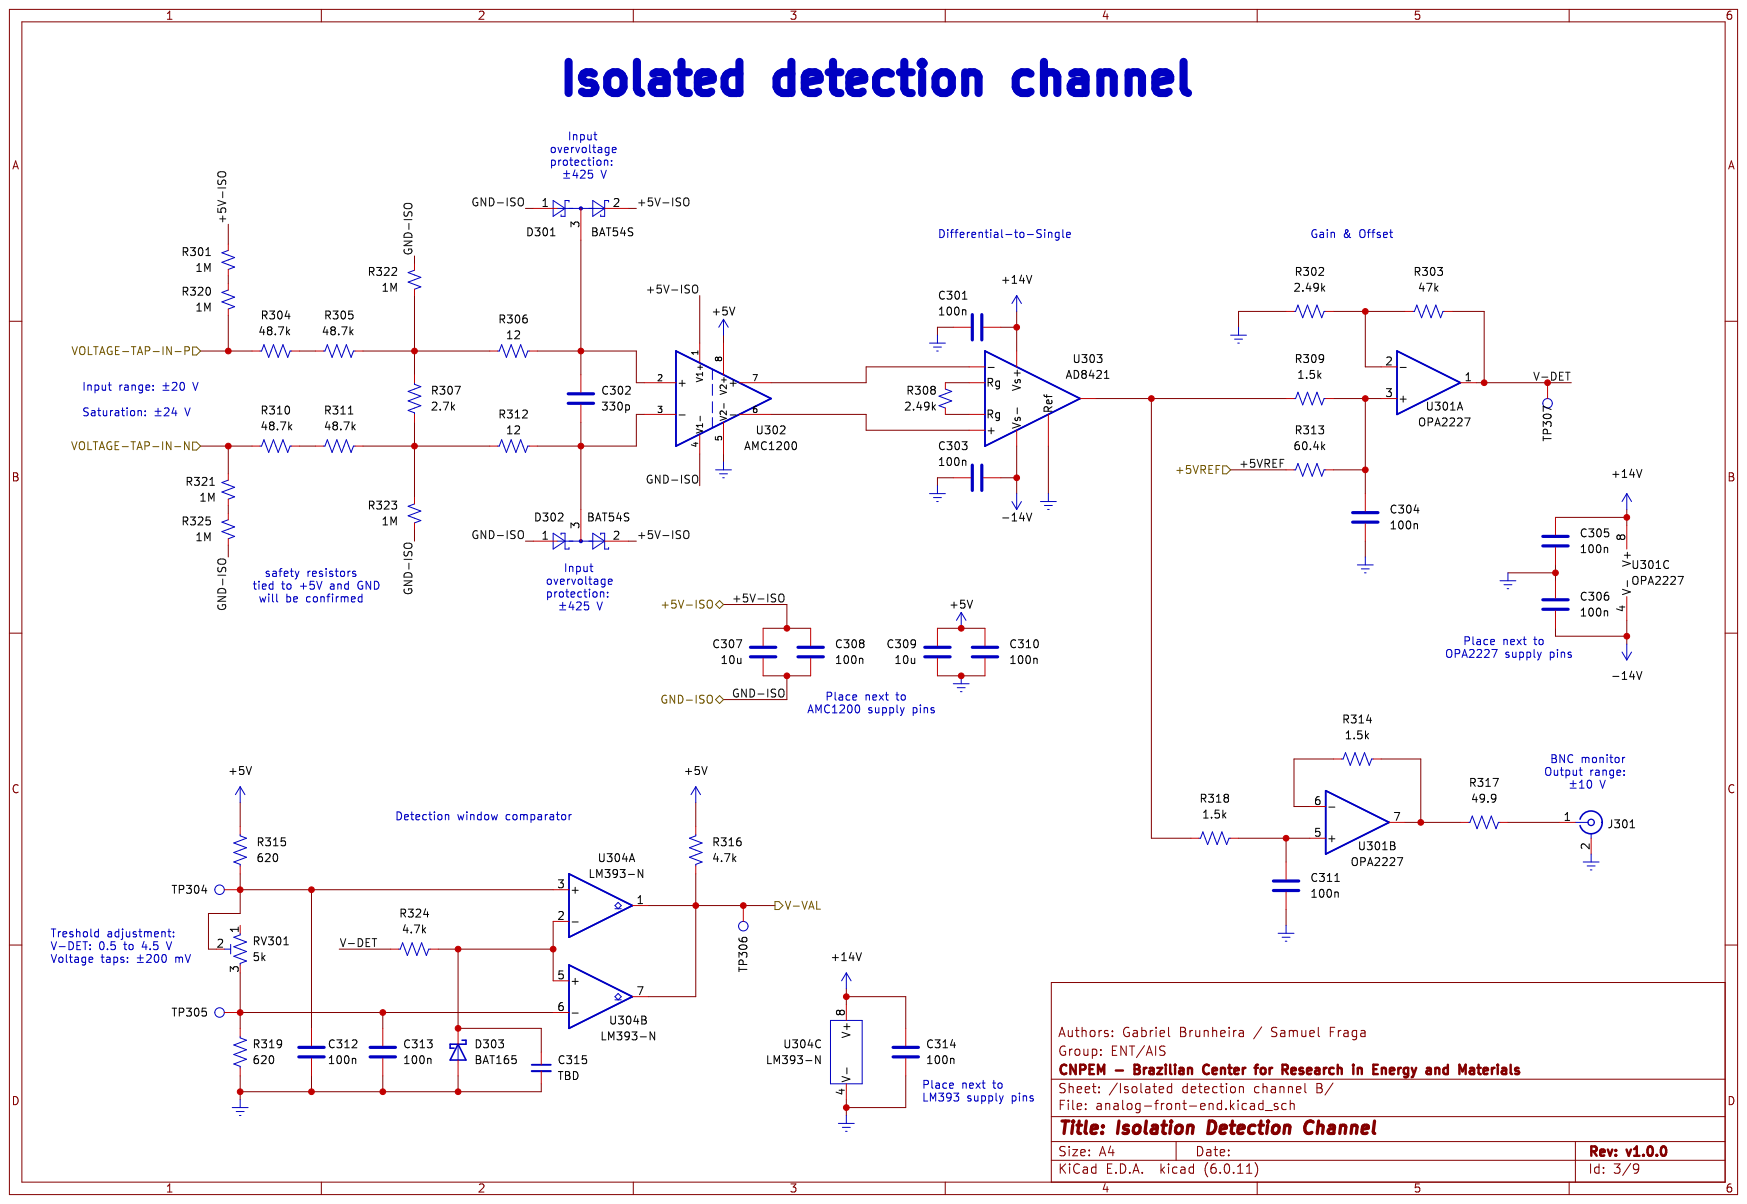
[picture p52: page 3]

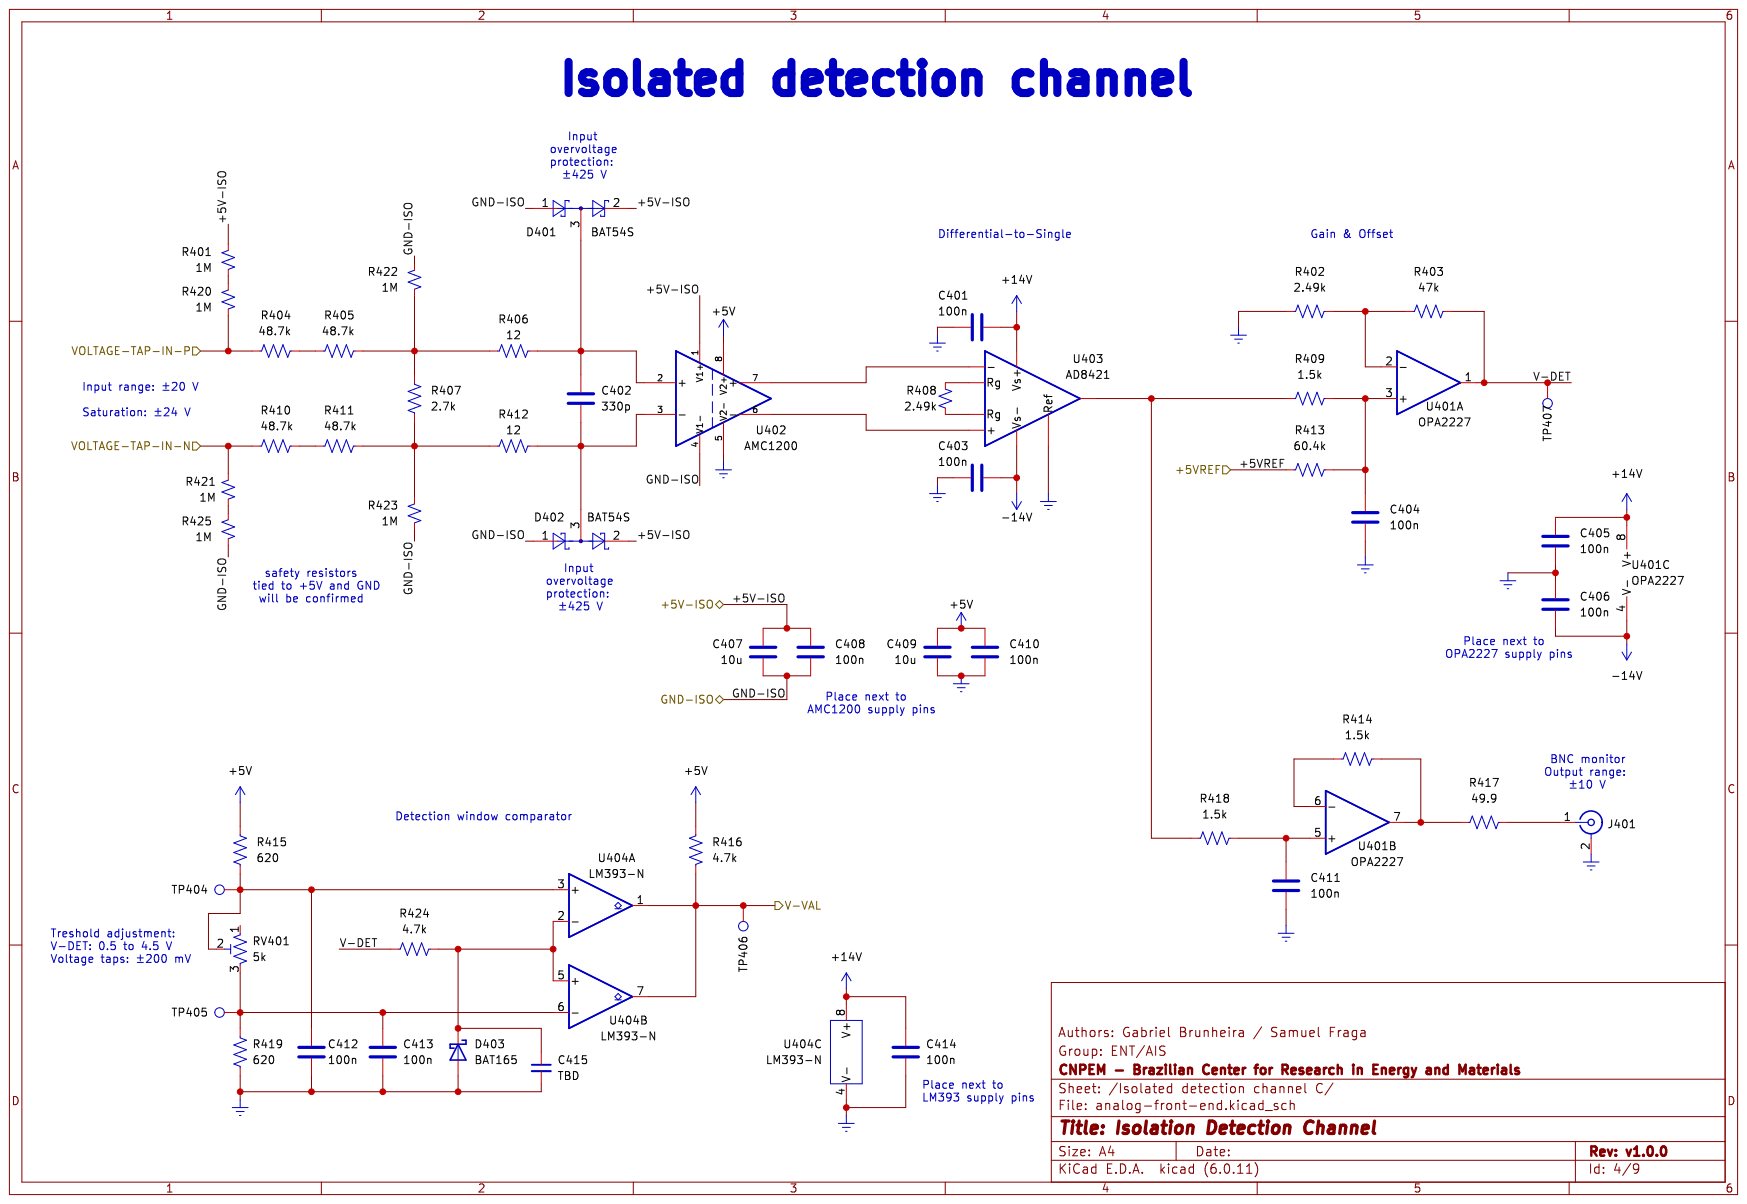
[picture p53: page 4]

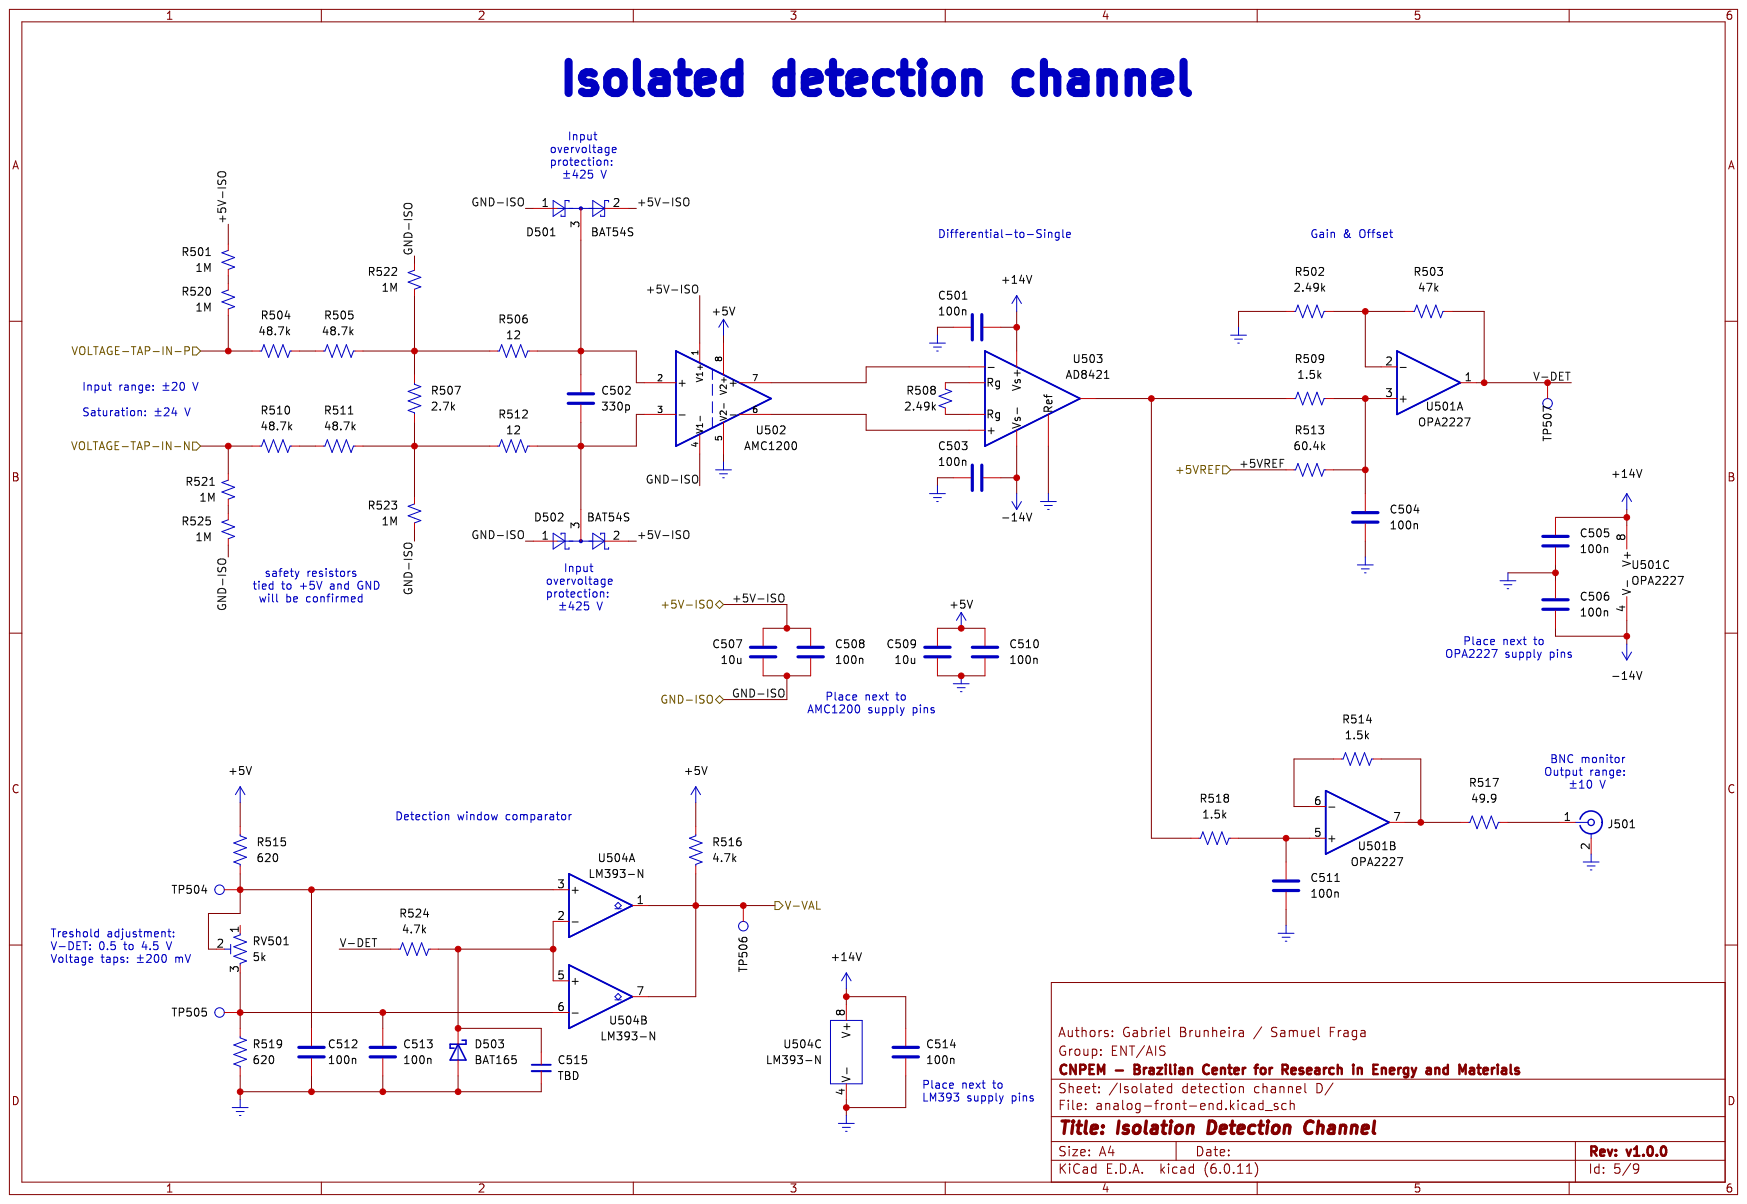
[picture p54: page 5]

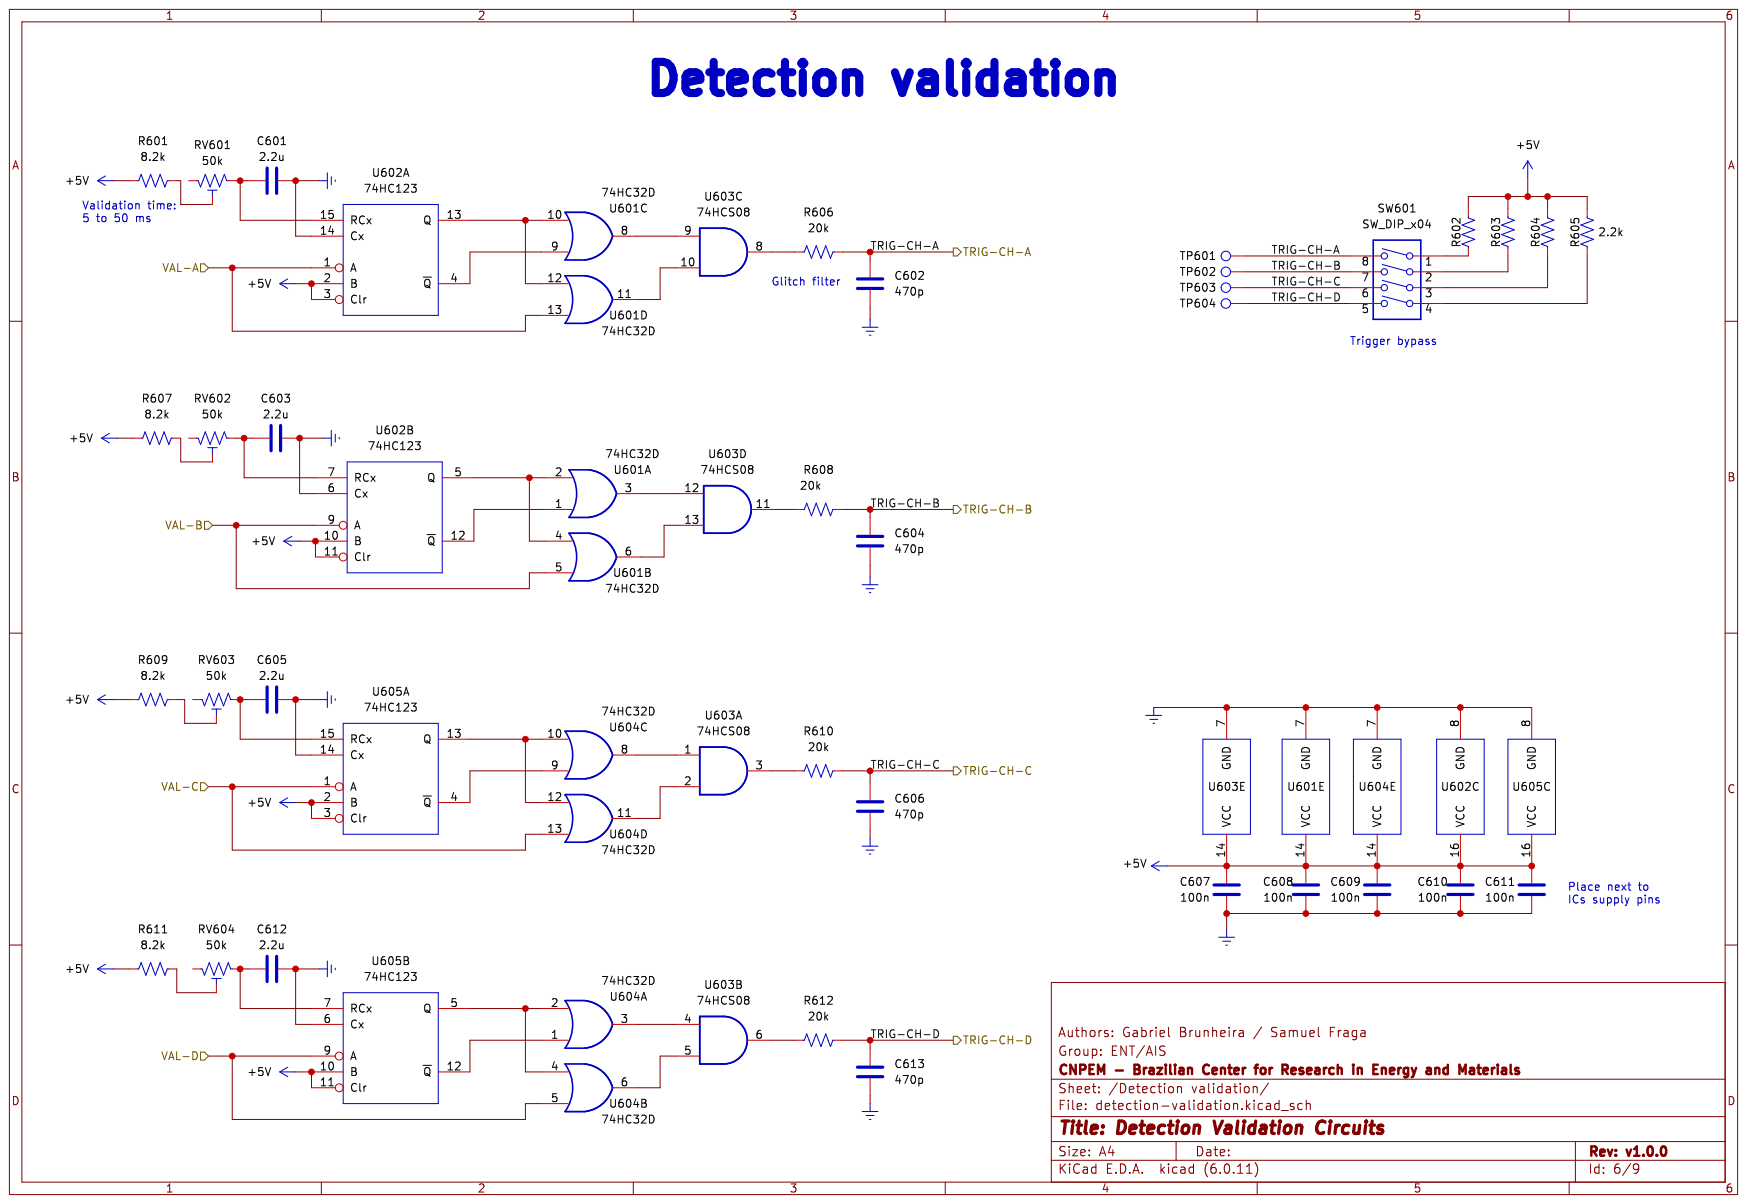
[picture p55: page 6]

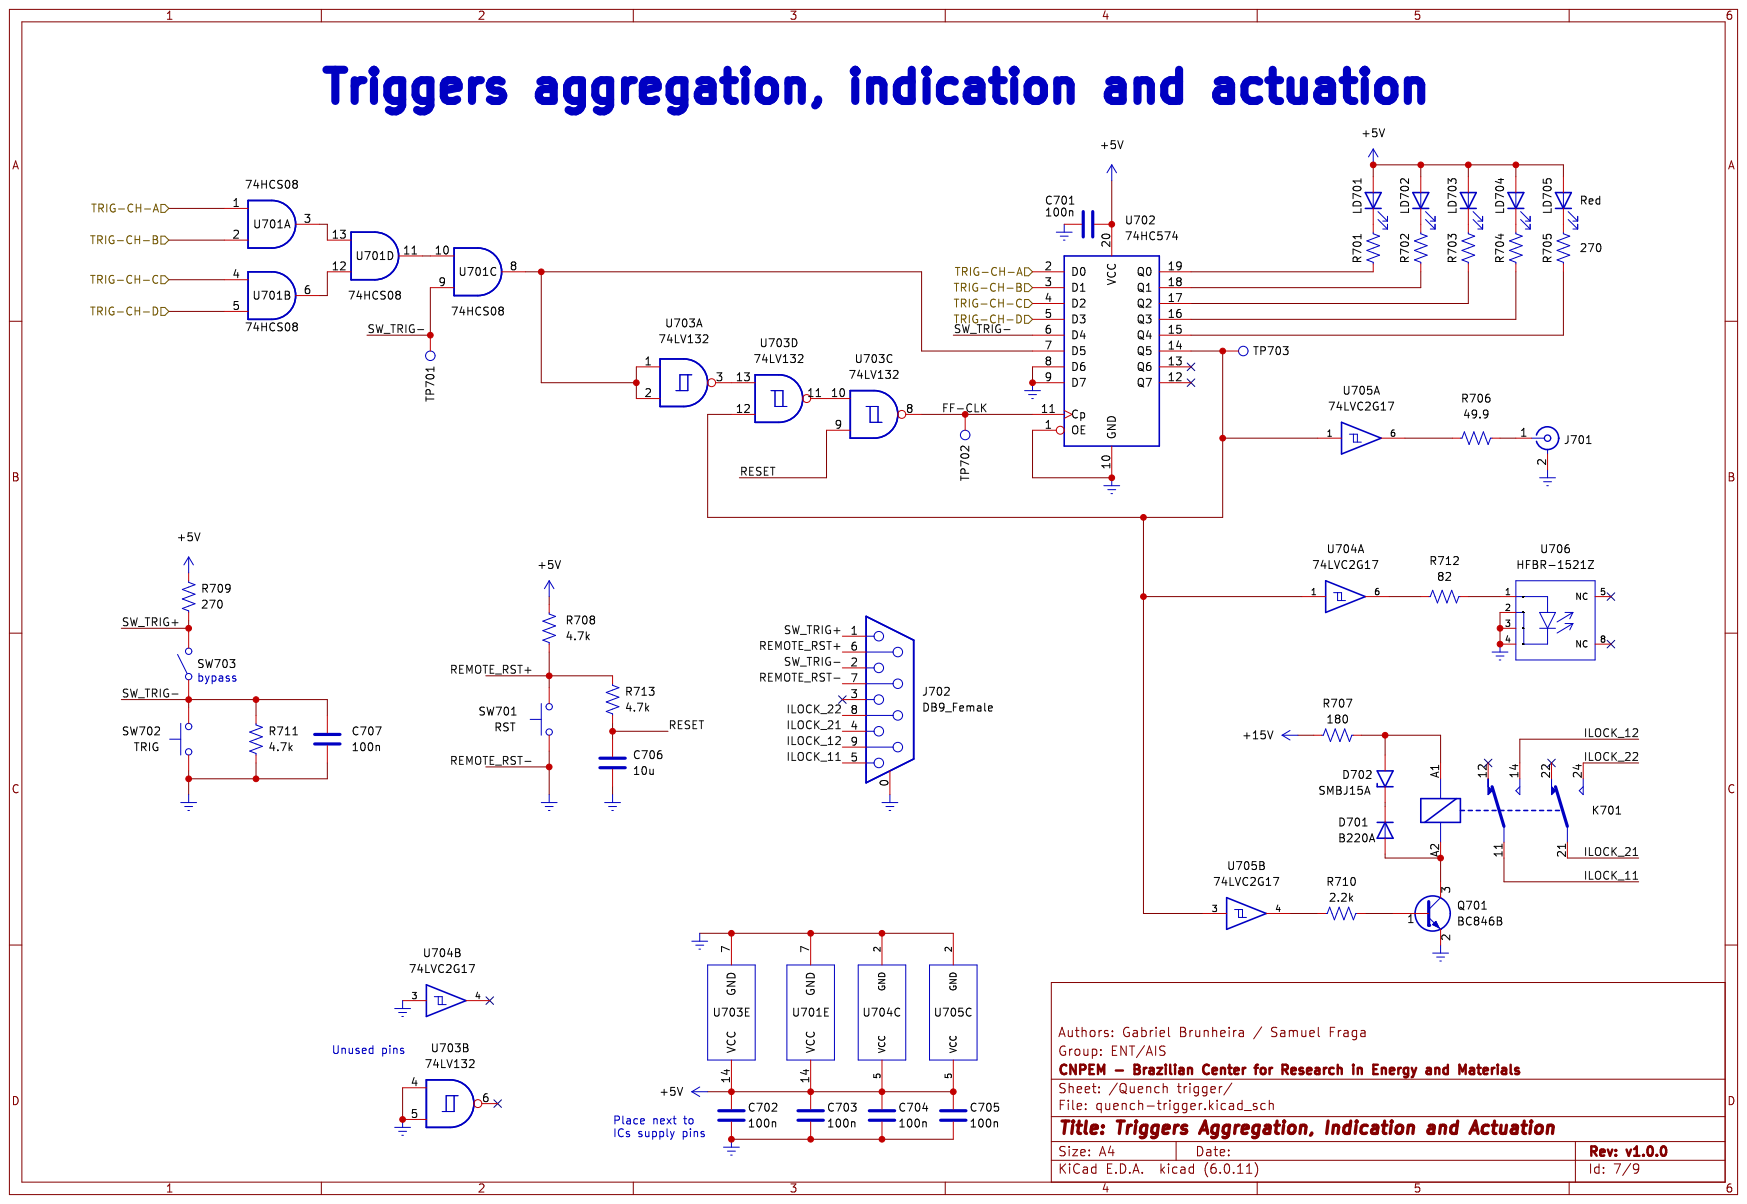
[picture p56: page 7]

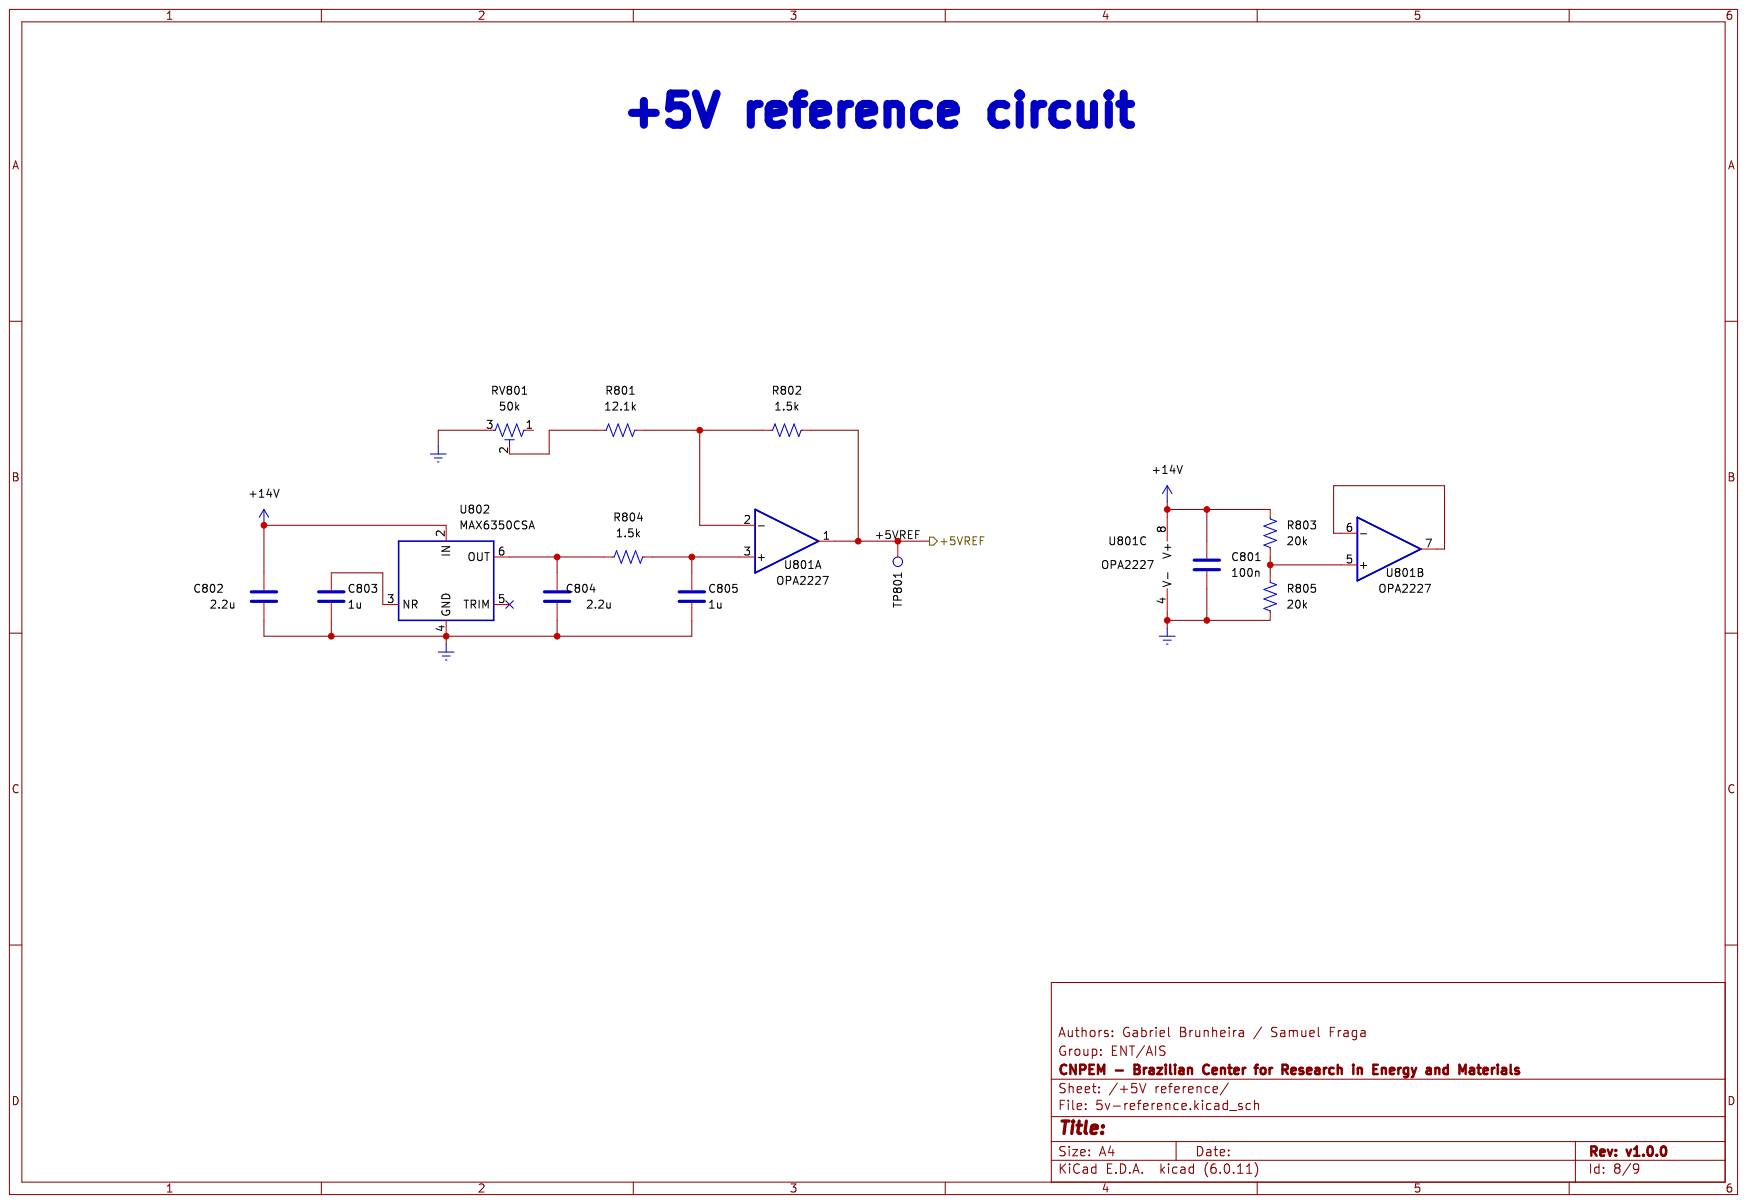
[picture p57: page 8]

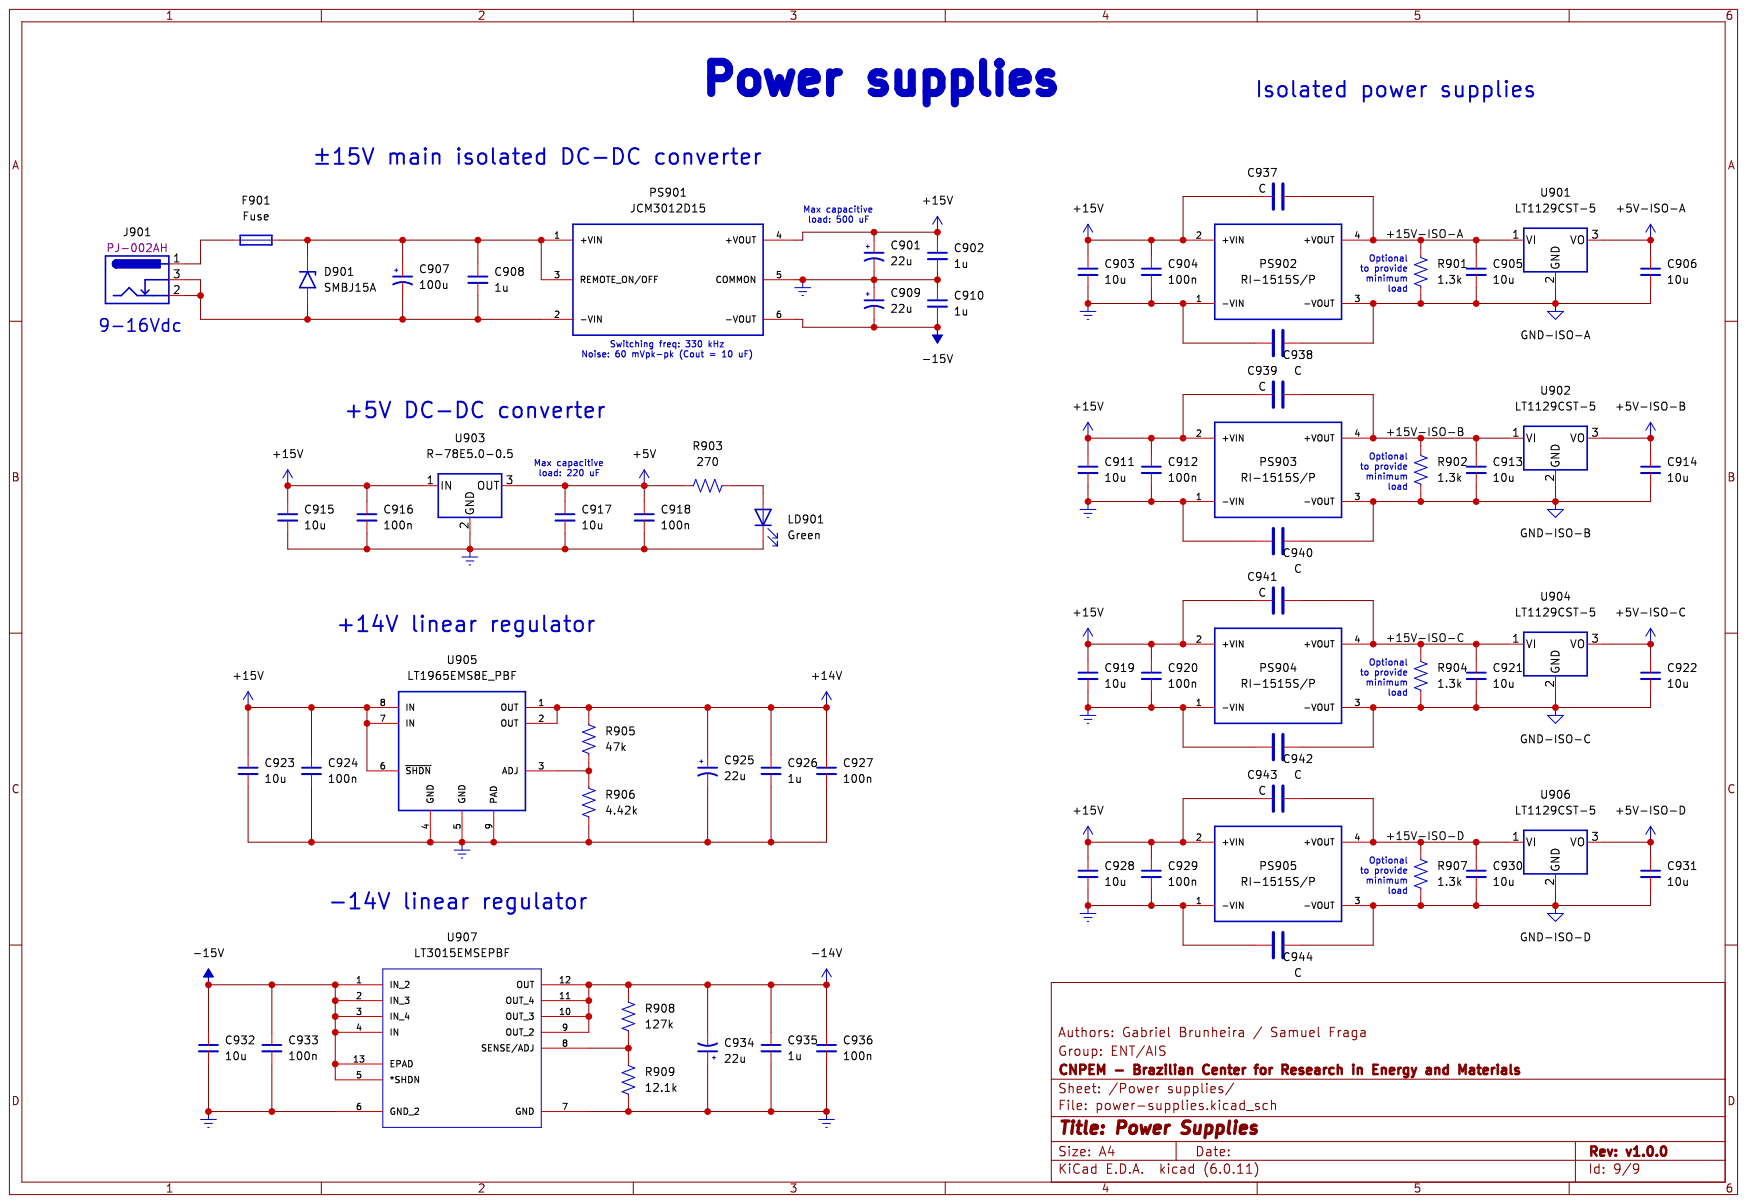
[picture p58: page 9]
