cnpem-emi/qds-cv-hw/simulation/validation.asc

C1: cap; 2.2µ
C2: cap; 470p
D1: diode
R1: res; 20k
R2: res; 1k
R3: res; 2k
S1: sw; mysw
U1: 74hc123; VCC=5  SPEED=1.0  TRIPDT=1e-5
U2: 74hc32; VCC=5  SPEED=1.0  TRIPDT=10e-9
U3: 74hc32; VCC=5  SPEED=1.0  TRIPDT=10e-9
U4: sn74hcs08
U5: sn74hcs08
U10: pot; Rtot=50K; wiper=0
V1: voltage; PULSE(5 0 240m 1u 1u 100m)
V2: voltage; 0
V3: voltage; PWL file=validation-vsource-50ms.txt
Named nets: 0, vcc, det_out, Q, Qn, Qo, prot
.tran 200m
.lib 74HC.lib
.model mysw SW(Ron=.01 Roff=1G Vt=0.5 Vh=0 Lser=0 Vser=0)
