cnpem-emi/qds-cv-hw/simulation/AMC1200-model-test.asc

C1: cap; 330p
R1: res; 1k noiseless
R2: res; 50k noiseless
R3: res; 50k noiseless
R4: res; 12
R5: res; 12
U1: AMC1200
U2: AMC1200
V1: voltage; 5
V2: voltage; 5
V3: voltage; 5
V4: voltage; PULSE(-50 50 0 1m 1m 1u 2m); AC 1
V5: voltage; 5
Named nets: 0, Vo+, Vo-, vinp, vinn, Vo1+, Vo1-, vinp1, vinn1
.tran 2m
