cnpem-emi/qds-cv-hw/simulation/AMC1200-step-test.asc

C1: cap; 330p
R1: res; 2.7k
R2: res; 100k
R3: res; 100k
R4: res; 12
R5: res; 12
U2: AMC1200
V1: voltage; 5
V2: voltage; 5
V4: voltage; ""; AC 1
Named nets: 0, Vo+, Vo-, vinp, vinn
.tran 0 1 0 1u
.param tal=10n
.dc v4 -0 60 2
.param Vp=500m
.ac dec 10 1k 100meg
