cnpem-emi/qds-cv-hw/simulation/full-broken-wire-detection-circuit-2.asc

R1: res; 2Meg
R2: res; 97.4k
R3: res; 97.4k
R4: res; 2.7k
R5: res; 2Meg
R6: res; 1Meg
R7: res; 1Meg
R8: res; 2Meg
R9: res; 97.4k
R10: res; 97.4k
R11: res; 2.7k
R12: res; 2Meg
R13: res; 1Meg
R14: res; 1Meg
R15: res; 2Meg
R16: res; 97.4k
R17: res; 97.4k
R18: res; 2.7k
R19: res; 2Meg
R20: res; 1Meg
R21: res; 1Meg
R22: res; 2Meg
R23: res; 97.4k
R24: res; 97.4k
R25: res; 2.7k
R26: res; 2Meg
R27: res; 1Meg
R28: res; 1Meg
R29: res; 1µ
R30: res; 1µ
R31: res; 1µ
R32: res; 2Meg
R33: res; 97.4k
R34: res; 97.4k
R35: res; 2.7k
R36: res; 2Meg
R37: res; 1Meg
R38: res; 1Meg
R39: res; 2Meg
R40: res; 97.4k
R41: res; 97.4k
R42: res; 2.7k
R43: res; 2Meg
R44: res; 1Meg
R45: res; 1Meg
R46: res; 2Meg
R47: res; 97.4k
R48: res; 97.4k
R49: res; 2.7k
R50: res; 2Meg
R51: res; 1Meg
R52: res; 1Meg
R53: res; 2Meg
R54: res; 97.4k
R55: res; 97.4k
R56: res; 2.7k
R57: res; 2Meg
R58: res; 1Meg
R59: res; 1Meg
R60: res; 1µ
R61: res; 1µ
R62: res; 1µ
R63: res; 1.5m
R64: res; 1.5m
R65: res; 0.25
R66: res; 1.5m
R67: res; 1.5m
R68: res; 0.25
R69: res; 2Meg
R70: res; 97.4k
R71: res; 97.4k
R72: res; 2.7k
R73: res; 2Meg
R74: res; 1Meg
R75: res; 1Meg
R76: res; 2Meg
R77: res; 97.4k
R78: res; 97.4k
R79: res; 2.7k
R80: res; 2Meg
R81: res; 1Meg
R82: res; 1Meg
R83: res
R84: res
R85: res
R86: res
R87: res
R88: res
R89: res
R90: res
S1: sw; MYSW
S2: sw; MYSW
S3: sw; MYSW
S4: sw; MYSW
S5: sw; MYSW
S6: sw; MYSW
S7: sw; MYSW
S8: sw; MYSW
S9: sw; MYSW
S10: sw; MYSW
S11: sw; MYSW
S12: sw; MYSW
U1: OP07
U2: OP07
V2: voltage; PULSE(1 0 1m 1n 1n 1m)
V3: voltage; PULSE(1 0 5m 1n 1n 1m)
V4: voltage; PULSE(1 0 9m 1n 1n 1m)
V5: voltage; PULSE(1 0 15m 1n 1n 1m)
V6: voltage; PULSE(1 0 3m 1n 1n 1m)
V7: voltage; PULSE(1 0 7m 1n 1n 1m)
V8: voltage; PULSE(1 0 11m 1n 1n 1m)
V9: voltage; PULSE(1 0 13m 1n 1n 1m)
V10: voltage; 5
V11: voltage; PULSE(1 0 1m 1n 1n 1m)
V12: voltage; PULSE(1 0 5m 1n 1n 1m)
V13: voltage; PULSE(1 0 9m 1n 1n 1m)
V14: voltage; PULSE(1 0 15m 1n 1n 1m)
V15: voltage; 5
V16: voltage; 5
V17: voltage; 5
V18: voltage; 5
V19: voltage; 5
V20: voltage; 5
V21: voltage; 5
Named nets: 0, vt1-a, vt2-a, vt3-b, vt4-c, vt2-b, vt3-c, vt4-d, vt1-d, vp-a, vn-a, vp-b, vn-b, vp-c, vn-c, vp-d, vn-d, vt1, vt2, vt3, vt4, vp-a2, vn-a2, vp-b2, vn-b2, vp-c2, vn-c2, vp-d2, vn-d2, Vcc, vcc1, vcc2, COM
.tran 17m
.model MYSW SW(Ron = 0.001m Roff = 1G Vt = 0.5 Vh = 0)
Without short between redundant voltage taps on QDS-CV
With short between redundant voltage taps on QDS-CV
This is a conceptual modification where the inputs of channel B have been inverted 
to make broken wire work for all voltage taps, even with shorts between channels.
