cnpem-emi/qds-cv-hw/simulation/input-overvoltage-protection-modified.asc

C1: cap; 330p
D1: schottky; BAT54
D2: schottky; BAT54
D3: schottky; BAT54
D4: schottky; BAT54
R1: res; 48.7k
R2: res; 48.7k
R3: res; 1.35k
R4: res; 48.7k
R5: res; 48.7k
R6: res; 12
R7: res; 12
R8: res; 1.35k
R9: res; 28k
R10: res; 0.95Meg
R11: res; 1.05Meg
V5-ISO: voltage; 5
Vin: voltage; 0
Named nets: 0, 5V-ISO, Vacm+, Vacm-
.dc Vin -1000 1000 10
;dc Vin -500 500 1
;dc Vin -40 40 1
;dc Vin -20 20 1
