cnpem-emi/qds-cv-hw/simulation/input-overvoltage-protection.asc

C1: cap; 330p
D1: schottky; BAT54
D2: schottky; BAT54
D3: schottky; BAT54
D5: schottky; BAT54
R1: res; 48.7k
R2: res; 48.7k
R3: res; 2.7k
R4: res; 48.7k
R5: res; 48.7k
R6: res; 12
R7: res; 12
R8: res; 28k
V5-ISO: voltage; 5
Vin: voltage; 0
Named nets: 0, 5V-ISO, Vacm+, Vacm-
.dc Vin -500 500 1
;dc Vin -20 20 1
