cnpem-emi/qds-cv-hw/simulation/sw-trigger-input-pertubation.asc

C1: cap; 100n
C2: cap; 100p
L2: ind; 1500n
R1: res; 4.7k
R2: res; 270
V1: voltage; 5
Vnoise: bv; V=10*(white(1e6*time))
Vpert: voltage; 0; AC 1
Named nets: 0, SW_TRIG, noise
;ac dec 10 10 10G
.tran 5m
