cnpem-emi/qds-cv-hw/simulation/window-comparator.asc

R1: res; 620
R3: res; 620
R4: res; 10k
U1: pot; Rtot=5K; wiper=.01
U5: LT1017
U6: LT1017
V1: voltage; 5
V2: voltage; PWL REPEAT FOR 2 (0 0 +5m 5 +5m 0) ENDREPEAT
Named nets: 0, vcc, in, out, Vh, Vl
.tran 20m
.lib opamp.sub
