cnpem-emi/qds-cv-hw/simulation/front-end-with-conditioning-circuit.asc

C1: cap; 100n
C2: cap; 100n
C3: cap; 330p
R1: res; 2490
R2: res; 620
R3: res; 620
R4: res; 14k
R5: res; 1500
R6: res; 1500
R7: res; 60400
R8: res; 50
R12: res; 12
R13: res; 12
R14: res; 1500
Rdiv: res; 2.7k
Rf: res; 47000
Rg: res; 2490
Rin1: res; 48.7k
Rin2: res; 48.7k
Rin3: res; 48.7k
Rin4: res; 48.7k
TR1: pot; Rtot=5K; wiper=0.5
U1: AD8421
U2: opamp
U3: opamp
U4: opamp
U5: AMC1200
V2: voltage; -14
V3: voltage; 14
VDD1: voltage; 5
VDD2: voltage; 5
Vin: voltage; 0; AC 1
Vref: voltage; 5
Named nets: 0, Vdet, Vmonitor, Vo+, Vo-, vinp, vinn
.dc Vin -0.2 0.2 0.01
;dc Vin -20 20 20
;ac dec 5 10 100k
;tran 1m
.lib opamp.sub
Differential to single-ended circuit
G = 5
Gain + offset circuit
G = 20, Offset = 2.5
Adjustable 5V reference for offset
5K trimpot for 
offset adj.
Low-pass filter
fcut = 1061 Hz (Vin)
fcut = 26 Hz (Vref)
...to window 
comparator circuit
...to buffered 
BNC monitor
Resistor for
stability under 
capacitive loads
(coaxial cables)
Isolated analog front-end
From voltage 
taps...
;step param RdivX 2670 2730 30
;step param RinX list 47500 48700 50000
