cnpem-emi/qds-cv-hw/simulation/trigger-indicator.asc

A1: dflop; Vhigh=1 Vlow=0; Trise=1u Tfall=1u Td=1u
A2: dflop; Vhigh=1 Vlow=0; Trise=1u Tfall=1u Td=1u
A3: dflop
A4: dflop
A6: and
A7: and
A8: and
V1: voltage; PULSE(1 0 1m 100n 100n 1m 2m 2)
V2: voltage; PULSE(1 0 1.5m 100n 100n 1m)
V3: voltage; 1
V4: voltage; 1
V5: voltage; 0
V6: voltage; PULSE(0 1 0 100n 100n 200u)
Named nets: 0, q1, clr, Qo1, clk, Qo2, q2, pre, Qo3, Qo4, q3, q4
.tran 0 10m 0
.options cshunt=1e-15
