cnpem-emi/qds-cv-hw/simulation/conditioning-circuit-crosstalk.asc

C1: cap; 100n
C2: cap; 100n
C3: cap; 100n
C4: cap; 100n
C5: cap; 100n
C6: cap; 100n
R1: res; 2490
R2: res; 620
R3: res; 620
R4: res; 14k
R5: res; 1500
R6: res; 1500
R7: res; 60400
R8: res; 50
R9: res; 2490
R10: res; 1500
R11: res; 1500
R12: res; 50
R13: res; 60400
R14: res; 2490
R15: res; 1500
R16: res; 1500
R17: res; 50
R18: res; 60400
Rf1: res; 47000
Rf2: res; 47000
Rf: res; 47000
Rg1: res; 2490
Rg2: res; 2490
Rg: res; 2490
TrimVref: res; 2256.4
U1: AD8421
U2: opamp
U3: opamp
U4: opamp
U5: AD8421
U6: opamp
U7: opamp
U8: AD8421
U9: opamp
U10: opamp
V1: voltage; -14
V2: voltage; -14
V3: voltage; 14
V4: voltage; 14
V5: voltage; -14
V6: voltage; 14
Vamc1: voltage; PULSE(-0.025 0.025 1m 1n 1n 10m)
Vamc2: voltage; 0
Vamc1200: voltage; 0; AC 1
Vref: voltage; 5
Named nets: 0, Vdet, Vmonitor, Vdet2, Vmonitor2, Vdet3, Vmonitor3
;dc Vamc1200 -0.025 0.025 0.01
.ac dec 5 10 100k
;tran 15m
.lib opamp.sub
Differential to single-ended circuit
G = 5
Gain + offset circuit
G = 20, Offset = 2.5
Adjustable 5V 
reference for offset
5K trimpot for 
offset adj.
Low-pass filter
fcut = 1061 Hz (Vin)
fcut = 26 Hz (Vref)
...to window 
comparator circuit
From AMC1200
isolation amplifier...
...to buffered 
BNC monitor
Resistor for
stability under 
capacitive loads
(coaxial cables)
5K trimpot for 
offset adj.
...to window 
comparator circuit
...to buffered 
BNC monitor
Resistor for
stability under 
capacitive loads
(coaxial cables)
5K trimpot for 
offset adj.
...to window 
comparator circuit
...to buffered 
BNC monitor
Resistor for
stability under 
capacitive loads
(coaxial cables)
