cnpem-emi/qds-cv-hw/simulation/conditioning-circuit.asc

C1: cap; 100n
C2: cap; 100n
R1: res; 2490
R2: res; 620
R3: res; 620
R4: res; 14k
R5: res; 1500
R6: res; 1500
R7: res; 60400
R8: res; 50
Rf: res; 47000
Rg: res; 2490
TrimVref: res; 2256.4
U1: AD8421
U2: opamp
U3: opamp
U4: opamp
V2: voltage; -14
V3: voltage; 14
Vamc1200: voltage; ""; AC 1
Vref: voltage; 5
Named nets: 0, Vdet, Vmonitor
;dc Vamc1200 -0.025 0.025 0.01
.dc Vamc1200 -2 2 0.1
;ac dec 5 10 100k
.lib opamp.sub
Differential to single-ended circuit
G = 5
Gain + offset circuit
G = 20, Offset = 2.5
Adjustable 5V reference for offset
5K trimpot for 
offset adj.
Low-pass filter
fcut = 1061 Hz (Vin)
fcut = 26 Hz (Vref)
...to window 
comparator circuit
From AMC1200
isolation amplifier...
...to buffered 
BNC monitor
Resistor for
stability under 
capacitive loads
(coaxial cables)
