cnpem-emi/qds-cv-hw/simulation/front-end-full.asc

C1: cap; 330p
C2: cap; 330p
C3: cap; 330p
C4: cap; 330p
Contactor1: sw; MYSW
D1: diode; Dlim
Dfw1: diode; Dideal
I1: current; {Iop}
I2: current; 1
L1: ind; {Lcentral}; Rser=0
R1: res; 100k
R2: res; 2.7k
R3: res; 100k
R4: res; R=V(Rq)
R5: res; 0.33
R6: res; 0.33
R7: res; 12
R8: res; 12
R9: res; 2.7k
R10: res; 100k
R11: res; 100k
R12: res; 12
R13: res; 12
R14: res; 2.7k
R15: res; 100k
R16: res; 100k
R17: res; 12
R18: res; 12
R19: res; 1m
R20: res; 1m
R21: res; 2.7k
R22: res; 100k
R23: res; 100k
R24: res; 12
R25: res; 12
U1: AMC1200
U2: AMC1200
U3: AMC1200
U4: AMC1200
V1: voltage; PULSE(1u 20m 10m 150m 1 5)
V2: voltage; PULSE(0 1 90m 1u 0 300m)
V3: voltage; 10
V4: voltage; 5
V5: voltage; 5
V6: voltage; 5
V7: voltage; 5
V8: voltage; 5
Named nets: 0, Rq, Vo+, Vo-, vinp, vinn, COM, Vo1+, Vo1-, vinp1, vinn1, Vo2+, Vo2-, vinp2, vinn2, VDD2, Vo3+, Vo3-, vinp3, vinn3, vt1, vt2, vt3, vt4
.ic I(L1)=Iop
.param Iop=300 Lcentral=38.5m Lside=14m
.step param Rquench 1u 20m 200u
.tran 300m
.model MYSW SW(Vt=0.9, Vh=1u, Ron=1000G, Roff=1u)
.model Dideal D(Ron=1u, Roff=1000G, Vfwd=1)
.model Dlim D(Ron=1u, Roff=1000G, Vfwd=0)
.option plotvntol=100e-6 plotabstol=10e-9 nomarch
