cnpem-emi/qds-cv-hw/simulation/SCW_disbalance_detector_v.asc

C1: cap; 10n
C2: cap; 10n
C3: cap; 0.1µ
C4: cap; 0.1µ
R1: res; 1k
R2: res; 100k
R3: res; 100k
R4: res; 3.3k
R5: res; 3.3k
R6: res; 680
R7: res; {X}
R8: res; 130
U1: TS37x
U2: TS37x
V1: voltage; 5
V2: voltage; SINE(0 1 10)
V3: voltage; 0
Named nets: 0, VCC, Vout, I1+, I1-, REF, J1
.tran 0 110m 0
.step param X list 1 100
