cnpem-emi/qds-cv-hw/pcb/cad/qds-cv.kicad_pcb

## KiCad design pcb/cad/qds-cv.kicad_pcb (2023-05-08)

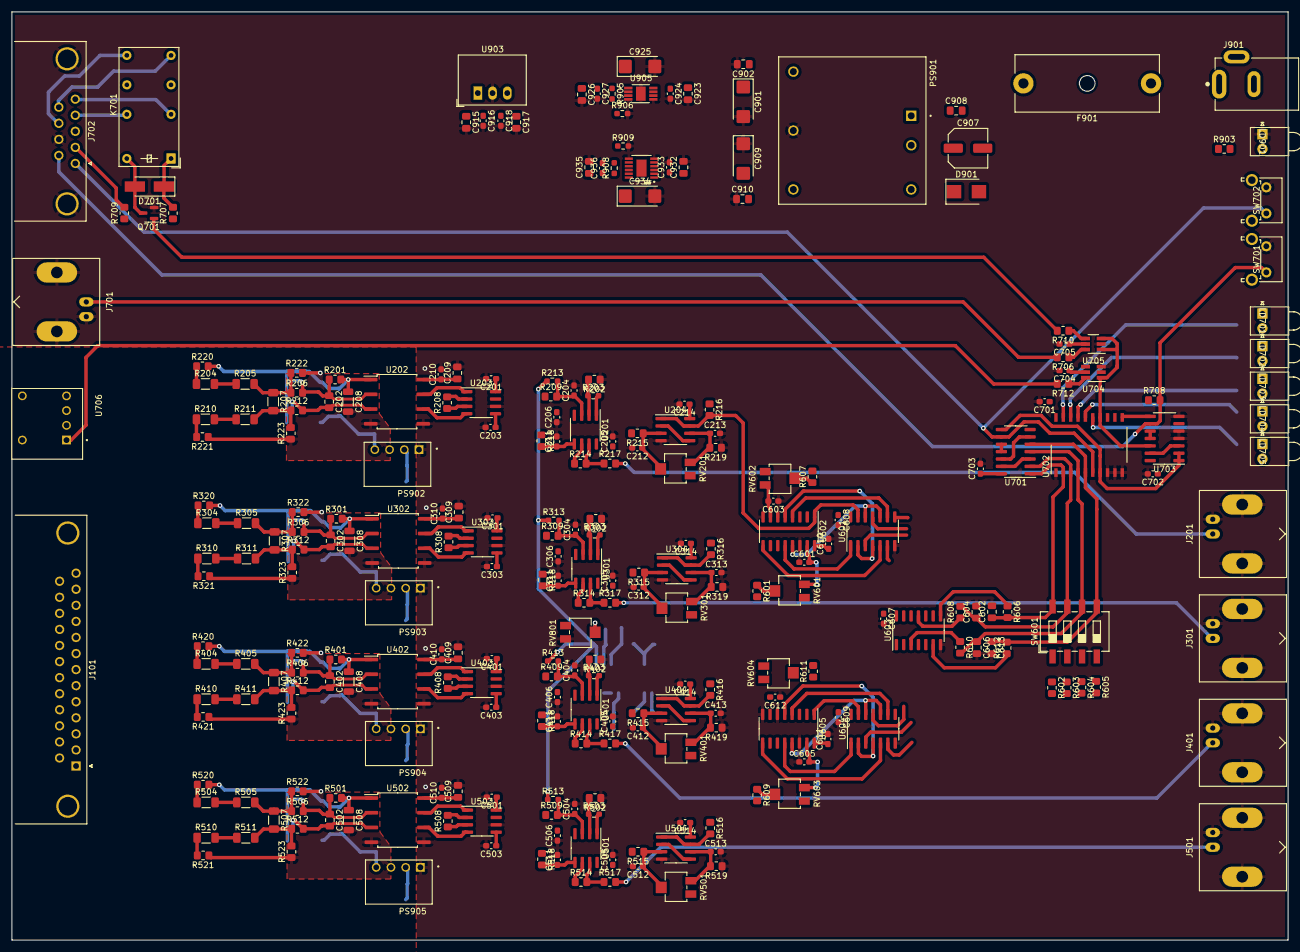
[picture p59: board qds-cv.kicad_pcb from above]

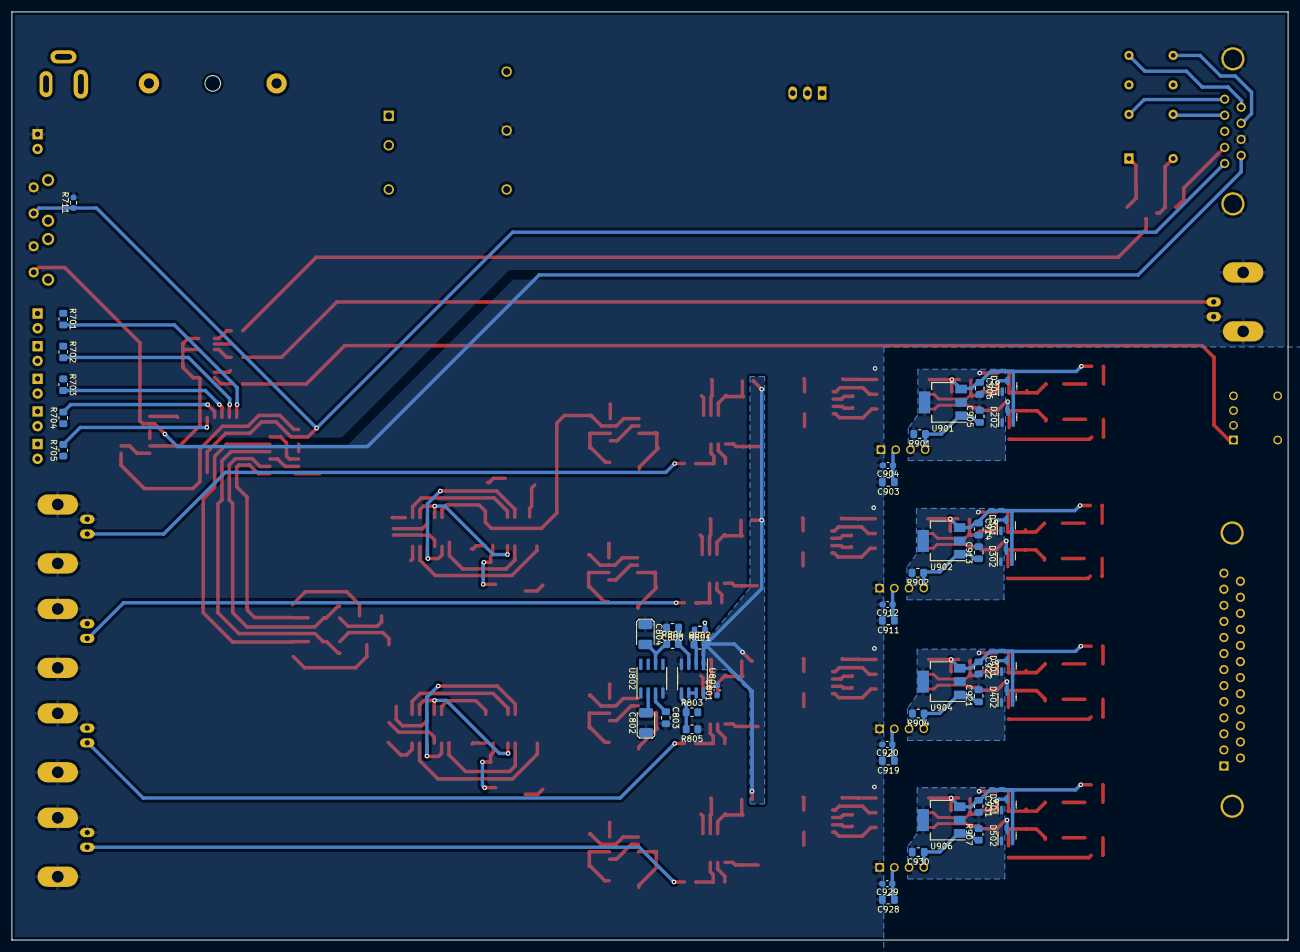
[picture p60: board qds-cv.kicad_pcb from below]

Board: 4 copper layers, 220.0 x 160.0 mm, 321 parts (50 on the bottom side), 189 nets.

Parts:
C201, C203, C204, C205, C206, C210, C211, C212, C213, C214, C301, C303, C304, C305, C306, C310, C311, C312, C313, C314, C401, C403, C404, C405, C406, C410, C411, C412, C413, C414, C501, C503, C504, C505, C506, C510, C511, C512, C513, C514, C607, C608, C609, C610, C611, C701, C702, C703, C704, C705, C801, C904, C912, C916, C918, C920, C924, C927, C929, C933, C936: 100n; C_0603_1608Metric_Pad1.08x0.95mm_HandSolder
C202, C302, C402, C502: 330p; C_0805_2012Metric_Pad1.18x1.45mm_HandSolder
C208, C308, C408, C508: 100n; C_1206_3216Metric_Small_Pad
C209, C309, C409, C509, C903, C905, C906, C911, C913, C914, C915, C917, C919, C921, C922, C923, C928, C930, C931, C932: 10u; C_0805_2012Metric_Pad1.18x1.45mm_HandSolder
C601, C603, C605, C612: 2.2u; C_0603_1608Metric_Pad1.08x0.95mm_HandSolder
C602, C604, C606, C613: 470p; C_0805_2012Metric_Pad1.18x1.45mm_HandSolder
C802, C804: 2.2u; CP_EIA-3528-21_AVX-B_Pad1.65x2.4mm_HandSolder
C803, C805, C902, C908, C910, C926, C935: 1u; C_0805_2012Metric_Pad1.18x1.45mm_HandSolder
C901, C909, C925, C934: 22u; CP_EIA-6032-28_Kemet-C_Pad2.25x2.35mm_HandSolder
C907: 100u; C_Elec_6.3x7.7
D201, D202, D301, D302, D401, D402, D501, D502: BAT54S; SOT-23
D701: B220A; D_SMA_Handsoldering
D901: SMBJ15A; D_SMB
F901: Fuse; ZH242
J101: DB25 Female; DSUB-25_Female_Horizontal_P2.77x2.84mm_EdgePinOffset7.70mm_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
J201, J301, J401, J501, J701: Conn_Coaxial; Molex_0731375003
J702: DB9_Female; DSUB-9_Female_Horizontal_P2.77x2.84mm_EdgePinOffset7.70mm_H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
J901: Barrel_Jack_Switch; CUI_PJ-002AH
K701: FINDER-30.22; Relay_DPDT_Finder_30.22
LD701, LD702, LD703, LD704, LD705: Red; LED_WP934CB_ID
LD901: Green; LED_WP934CB_GD
PS901: JCM3012D15; JCM30
PS902, PS903, PS904, PS905: RI-1515S/P; RI-1515S
Q701: BC846B; SOT-23
R201, R301, R401, R501: NP; R_0805_2012Metric_Pad1.20x1.40mm_HandSolder
R202, R208, R302, R308, R402, R408, R502, R508: 2.49k; R_0805_2012Metric_Pad1.20x1.40mm_HandSolder
R203, R303, R403, R503, R711, R905: 47k; R_0603_1608Metric_Pad0.98x0.95mm_HandSolder
R204, R205, R210, R211, R304, R305, R310, R311, R404, R405, R410, R411, R504, R505, R510, R511: 48.7k; R_1206_3216Metric_Pad1.30x1.75mm_HandSolder
R206, R212, R306, R312, R406, R412, R506, R512: 12; R_0805_2012Metric_Pad1.20x1.40mm_HandSolder
R207, R307, R407, R507: 2.7k; R_1206_3216Metric_Pad1.30x1.75mm_HandSolder
R209, R214, R218, R309, R314, R318, R409, R414, R418, R509, R514, R518: 1.5k; R_0805_2012Metric_Pad1.20x1.40mm_HandSolder
R213, R313, R413, R513: 60.4k; R_0603_1608Metric_Pad0.98x0.95mm_HandSolder
R215, R219, R315, R319, R415, R419, R515, R519, R802, R804: 620; R_0805_2012Metric_Pad1.20x1.40mm_HandSolder
R216, R316, R416, R516, R601, R607, R609, R611, R708, R709: 4.7k; R_0805_2012Metric_Pad1.20x1.40mm_HandSolder
R217, R317, R417, R517, R706: 49.9; R_0805_2012Metric_Pad1.20x1.40mm_HandSolder
R220, R221, R320, R321, R420, R421, R520, R521: 2M; R_0805_2012Metric_Pad1.20x1.40mm_HandSolder
R222, R223, R322, R323, R422, R423, R522, R523: 1M; R_0805_2012Metric_Pad1.20x1.40mm_HandSolder
R602, R603, R604, R605, R710: 2.2k; R_0805_2012Metric_Pad1.20x1.40mm_HandSolder
R606, R608, R610, R612, R803, R805: 20k; R_0805_2012Metric_Pad1.20x1.40mm_HandSolder
R701, R702, R703, R704, R705, R903: 270; R_0805_2012Metric_Pad1.20x1.40mm_HandSolder
R707: 180; R_0805_2012Metric_Pad1.20x1.40mm_HandSolder
R712: 82; R_0805_2012Metric_Pad1.20x1.40mm_HandSolder
R801: 14k; R_0603_1608Metric_Pad0.98x0.95mm_HandSolder
R901, R902, R904, R907: 1.3k; R_0805_2012Metric_Pad1.20x1.40mm_HandSolder
R906: 4.42k; R_0603_1608Metric_Pad0.98x0.95mm_HandSolder
R908: 127k; R_0603_1608Metric_Pad0.98x0.95mm_HandSolder
R909: 12.1k; R_0603_1608Metric_Pad0.98x0.95mm_HandSolder
RV201, RV301, RV401, RV501, RV801: 5k; Potentiometer_Bourns_3224X_Vertical
RV601, RV602, RV603, RV604: 50k; Potentiometer_Bourns_3224X_Vertical
SW601: SW_DIP_x04; SW_DIP_SPSTx04_Slide_6.7x11.72mm_W8.61mm_P2.54mm_LowProfile
SW701: RST; SW_Tactile_SPST_Angled_PTS645Vx39-2LFS
SW702: TRIG; SW_Tactile_SPST_Angled_PTS645Vx39-2LFS
U201, U301, U401, U501, U801: OPA2227; SOIC-8_3.9x4.9mm_P1.27mm
U202, U302, U402, U502: AMC1200; SOP-8_6.62x9.15mm_P2.54mm
U203, U303, U403, U503: AD8421; SOIC-8_3.9x4.9mm_P1.27mm
U204, U304, U404, U504: LM393-N; SOIC-8_3.9x4.9mm_P1.27mm
U601, U604: 74HC32D; SO-14_3.9x8.65mm_P1.27mm
U602, U605: 74HC123; SOIC-16_3.9x9.9mm_P1.27mm
U603, U701: 74HCS08; SO-14_3.9x8.65mm_P1.27mm
U702: 74HC574; SO-20_12.8x7.5mm_P1.27mm
U703: 74LV132; SO-14_3.9x8.65mm_P1.27mm
U704, U705: 74LVC2G17; SOT-23-6_Handsoldering
U706: HFBR-1521Z
U802: MAX6350CSA; SOIC-8_3.9x4.9mm_P1.27mm
U901, U902, U904, U906: LT1129CST-5; SOT-223-3_TabPin2
U903: R-78E5.0-0.5; Converter_DCDC_RECOM_R-78E-0.5_THT
U905: LT1965EMS8E_PBF; SOP65P490X110-9N
U907: LT3015EMSEPBF; MSOP-12_MSE

Connections:
+5V: C209.1, C210.1, C309.1, C310.1, C409.1, C410.1, C509.1, C510.1, C607.1, C608.1, C609.1, C610.1, C611.1, C701.1, C702.1, C703.1, C704.1, C705.1, C917.1, C918.1, LD701.2 (A), LD702.2 (A), LD703.2 (A), LD704.2 (A), LD705.2 (A), R215.2, R216.1, R315.2, R316.1, R415.2, R416.1, R515.2, R516.1, R601.2, R602.2, R603.2, R604.2, R605.2, R607.2, R609.2, R611.2, R708.1, R709.1, R903.1, U202.8 (V2+), U302.8 (V2+), U402.8 (V2+), U502.8 (V2+), U601.14 (VCC), U602.2 (B), U602.3 (Clr), U602.10 (B), U602.11 (Clr), U602.16 (VCC), U603.14 (VCC), U604.14 (VCC), U605.2 (B), U605.3 (Clr), U605.10 (B), U605.11 (Clr), U605.16 (VCC), U701.14 (VCC), U702.20 (VCC), U703.14 (VCC), U704.5 (VCC), U705.5 (VCC), U903.3 (OUT)
+5V-ISO-A: C208.1, C906.1, D201.2, D202.2, R201.2, R220.2, U202.1 (V1+), U901.3 (VO)
+5V-ISO-B: C308.1, C914.1, D301.2, D302.2, R301.2, R320.2, U302.1 (V1+), U902.3 (VO)
+5V-ISO-C: C408.1, C922.1, D401.2, D402.2, R401.2, R420.2, U402.1 (V1+), U904.3 (VO)
+5V-ISO-D: C508.1, C931.1, D501.2, D502.2, R501.2, R520.2, U502.1 (V1+), U906.3 (VO)
+14V: C201.1, C205.1, C214.1, C301.1, C305.1, C314.1, C401.1, C405.1, C414.1, C501.1, C505.1, C514.1, C801.1, C802.2, C925.1, C926.1, C927.1, R803.2, R905.1, U201.8 (V+), U203.8 (Vs+), U204.8 (V+), U301.8 (V+), U303.8 (Vs+), U304.8 (V+), U401.8 (V+), U403.8 (Vs+), U404.8 (V+), U501.8 (V+), U503.8 (Vs+), U504.8 (V+), U801.8 (V+), U802.2 (IN), U905.1 (OUT), U905.2 (OUT)
+15V: C901.1, C902.1, C903.1, C904.1, C911.1, C912.1, C915.1, C916.1, C919.1, C920.1, C923.1, C924.1, C928.1, C929.1, PS901.4 (+VOUT), PS902.2 (+VIN), PS903.2 (+VIN), PS904.2 (+VIN), PS905.2 (+VIN), R707.1, U903.1 (IN), U905.6 (~SHDN), U905.7 (IN), U905.8 (IN)
-14V: C203.1, C206.2, C303.1, C306.2, C403.1, C406.2, C503.1, C506.2, C934.1, C935.1, C936.1, R908.1, U201.4 (V-), U203.5 (Vs-), U301.4 (V-), U303.5 (Vs-), U401.4 (V-), U403.5 (Vs-), U501.4 (V-), U503.5 (Vs-), U907.9 (OUT_2), U907.10 (OUT_3), U907.11 (OUT_4), U907.12 (OUT)
-15V: C909.2, C910.2, C932.1, C933.1, PS901.6 (-VOUT), U907.1 (IN_2), U907.2 (IN_3), U907.3 (IN_4), U907.4 (IN), U907.5 (*SHDN), U907.13 (EPAD)
/+5V reference/+5VREF: R213.1, R313.1, R413.1, R513.1, R802.2, U801.1
/Detection validation/TRIG-CH-A: C602.1, R606.2, SW601.8, U701.1, U702.2 (D0)
/Detection validation/TRIG-CH-B: C604.1, R608.2, SW601.7, U701.2, U702.3 (D1)
/Detection validation/TRIG-CH-C: C606.1, R610.2, SW601.6, U701.4, U702.4 (D2)
/Detection validation/TRIG-CH-D: C613.1, R612.2, SW601.5, U701.5, U702.5 (D3)
/Detection validation/VAL-A: R216.2, U204.1, U204.7, U601.13, U602.1 (A)
/Detection validation/VAL-B: R316.2, U304.1, U304.7, U601.5, U602.9 (A)
/Detection validation/VAL-C: R416.2, U404.1, U404.7, U604.13, U605.1 (A)
/Detection validation/VAL-D: R516.2, U504.1, U504.7, U604.5, U605.9 (A)
/Isolated detection channel A/V-DET: R203.2, U201.1, U204.2 (-), U204.5 (+)
/Isolated detection channel B/V-DET: R303.2, U301.1, U304.2 (-), U304.5 (+)
/Isolated detection channel C/V-DET: R403.2, U401.1, U404.2 (-), U404.5 (+)
/Isolated detection channel D/V-DET: R503.2, U501.1, U504.2 (-), U504.5 (+)
/Power supplies/+15V-ISO-A: C905.1, PS902.4 (+VOUT), R901.1, U901.1 (VI)
/Power supplies/+15V-ISO-B: C913.1, PS903.4 (+VOUT), R902.1, U902.1 (VI)
/Power supplies/+15V-ISO-C: C921.1, PS904.4 (+VOUT), R904.1, U904.1 (VI)
/Power supplies/+15V-ISO-D: C930.1, PS905.4 (+VOUT), R907.1, U906.1 (VI)
/Quench trigger/ILOCK_11: J702.5, K701.11
/Quench trigger/ILOCK_12: J702.9, K701.14
/Quench trigger/ILOCK_21: J702.4, K701.21
/Quench trigger/ILOCK_22: J702.8, K701.24
/Quench trigger/REMOTE_RST+: J702.6, R708.2, SW701.2, U703.9
/Quench trigger/SW_TRIG+: J702.2, R709.2
/Quench trigger/SW_TRIG-: J702.1, R711.1, SW702.2, U701.9, U702.6 (D4)
/VT1: J101.12, J101.24, R204.1, R220.1, R504.1, R520.1
/VT2: J101.9, J101.21, R210.1, R221.2, R304.1, R320.1
/VT3: J101.5, J101.18, R310.1, R321.2, R404.1, R420.1
/VT4: J101.2, J101.15, R410.1, R421.2, R510.1, R521.2
Earth: C201.2, C203.2, C204.2, C205.2, C206.1, C209.2, C210.2, C211.2, C212.2, C213.2, C214.2, C301.2, C303.2, C304.2, C305.2, C306.1, C309.2, C310.2, C311.2, C312.2, C313.2, C314.2, C401.2, C403.2, C404.2, C405.2, C406.1, C409.2, C410.2, C411.2, C412.2, C413.2, C414.2, C501.2, C503.2, C504.2, C505.2, C506.1, C509.2, C510.2, C511.2, C512.2, C513.2, C514.2, C601.1, C602.2, C603.1, C604.2, C605.1, C606.2, C607.2, C608.2, C609.2, C610.2, C611.2, C612.1, C613.2, C701.2, C702.2, C703.2, C704.2, C705.2, C801.2, C802.1, C803.2, C804.1, C805.2, C901.2, C902.2, C903.2, C904.2, C909.1, C910.1, C911.2, C912.2, C915.2, C916.2, C917.2, C918.2, C919.2, C920.2, C923.2, C924.2, C925.2, C926.2, C927.2, C928.2, C929.2, C932.2, C933.2, C934.2, C935.2, C936.2, J101.0 (PAD), J201.2 (Ext), J301.2 (Ext), J401.2 (Ext), J501.2 (Ext), J701.2 (Ext), J702.0 (PAD), J702.7, LD901.1 (K), PS901.5 (COMMON), PS902.1 (-VIN), PS903.1 (-VIN), PS904.1 (-VIN), PS905.1 (-VIN), Q701.2 (E), R202.1, R219.1, R302.1, R319.1, R402.1, R419.1, R502.1, R519.1, R711.2, R805.1, R906.2, R909.2, RV801.3, SW701.1, SW702.1, U202.5 (V2-), U203.6 (Ref), U204.4 (V-), U302.5 (V2-), U303.6 (Ref), U304.4 (V-), U402.5 (V2-), U403.6 (Ref), U404.4 (V-), U502.5 (V2-), U503.6 (Ref), U504.4 (V-), U601.7 (GND), U602.6 (Cx), U602.8 (GND), U602.14 (Cx), U603.7 (GND), U604.7 (GND), U605.6 (Cx), U605.8 (GND), U605.14 (Cx), U701.7 (GND), U702.1 (OE), U702.8 (D6), U702.9 (D7), U702.10 (GND), U703.4, U703.5, U703.7 (GND), U704.2 (GND), U704.3, U705.2 (GND), U706.2 (Cathode), U706.3 (NC), U706.4 (NC), U801.4 (V-), U802.4 (GND), U903.2 (GND), U905.4 (GND), U905.5 (GND), U905.9 (PAD), U907.6 (GND_2), U907.7 (GND)
GND-ISO-A: C208.2, C905.2, C906.2, D201.1, D202.1, PS902.3 (-VOUT), R221.1, R222.2, R223.1, R901.2, U202.4 (V1-), U901.2 (GND)
GND-ISO-B: C308.2, C913.2, C914.2, D301.1, D302.1, PS903.3 (-VOUT), R321.1, R322.2, R323.1, R902.2, U302.4 (V1-), U902.2 (GND)
GND-ISO-C: C408.2, C921.2, C922.2, D401.1, D402.1, PS904.3 (-VOUT), R421.1, R422.2, R423.1, R904.2, U402.4 (V1-), U904.2 (GND)
GND-ISO-D: C508.2, C930.2, C931.2, D501.1, D502.1, PS905.3 (-VOUT), R521.1, R522.2, R523.1, R907.2, U502.4 (V1-), U906.2 (GND)
unnamed: C202.1, D201.3, R201.1, R206.2, U202.2 (+)
unnamed: C202.2, D202.3, R212.2, U202.3 (-)
unnamed: C204.1, R209.2, R213.2, U201.3 (+)
unnamed: C211.1, R218.2, U201.5 (+)
unnamed: C212.1, R215.1, RV201.2, U204.3 (+)
unnamed: C213.1, R219.2, RV201.3, U204.6 (-)
unnamed: C302.1, D301.3, R301.1, R306.2, U302.2 (+)
unnamed: C302.2, D302.3, R312.2, U302.3 (-)
unnamed: C304.1, R309.2, R313.2, U301.3 (+)
unnamed: C311.1, R318.2, U301.5 (+)
unnamed: C312.1, R315.1, RV301.2, U304.3 (+)
unnamed: C313.1, R319.2, RV301.3, U304.6 (-)
unnamed: C402.1, D401.3, R401.1, R406.2, U402.2 (+)
unnamed: C402.2, D402.3, R412.2, U402.3 (-)
unnamed: C404.1, R409.2, R413.2, U401.3 (+)
unnamed: C411.1, R418.2, U401.5 (+)
unnamed: C412.1, R415.1, RV401.2, U404.3 (+)
unnamed: C413.1, R419.2, RV401.3, U404.6 (-)
unnamed: C502.1, D501.3, R501.1, R506.2, U502.2 (+)
unnamed: C502.2, D502.3, R512.2, U502.3 (-)
unnamed: C504.1, R509.2, R513.2, U501.3 (+)
unnamed: C511.1, R518.2, U501.5 (+)
unnamed: C512.1, R515.1, RV501.2, U504.3 (+)
unnamed: C513.1, R519.2, RV501.3, U504.6 (-)
unnamed: C601.2, RV601.3, U602.15 (RCx)
unnamed: C603.2, RV602.3, U602.7 (RCx)
unnamed: C605.2, RV603.3, U605.15 (RCx)
unnamed: C612.2, RV604.2, U605.7 (RCx)
unnamed: C803.1, U802.3 (NR)
unnamed: C804.2, R804.1, U802.6 (OUT)
unnamed: C805.1, R804.2, U801.3 (+)
unnamed: C907.1, C908.1, D901.1 (A1), F901.2, PS901.1 (+VIN), PS901.3 (REMOTE_ON/OFF)
unnamed: C907.2, C908.2, D901.2 (A2), J901.2, J901.3, PS901.2 (-VIN)
unnamed: D701.1 (K), K701.A1, R707.2
unnamed: D701.2 (A), K701.A2, Q701.3 (C)
unnamed: F901.1, J901.1
unnamed: J201.1 (In), R217.2
unnamed: J301.1 (In), R317.2
unnamed: J401.1 (In), R417.2
unnamed: J501.1 (In), R517.2
unnamed: J701.1 (In), R706.2
unnamed: LD701.1 (K), R701.1
unnamed: LD702.1 (K), R702.1
unnamed: LD703.1 (K), R703.1
unnamed: LD704.1 (K), R704.1
unnamed: LD705.1 (K), R705.1
unnamed: LD901.2 (A), R903.2
unnamed: Q701.1 (B), R710.2
unnamed: R202.2, R203.1, U201.2 (-)
unnamed: R204.2, R205.1
unnamed: R205.2, R206.1, R207.1, R222.1
unnamed: R207.2, R211.2, R212.1, R223.2
unnamed: R208.1, U203.3 (Rg)
unnamed: R208.2, U203.2 (Rg)
unnamed: R209.1, R218.1, U203.7
unnamed: R210.2, R211.1
unnamed: R214.1, U201.6 (-)
unnamed: R214.2, R217.1, U201.7
unnamed: R302.2, R303.1, U301.2 (-)
unnamed: R304.2, R305.1
unnamed: R305.2, R306.1, R307.1, R322.1
unnamed: R307.2, R311.2, R312.1, R323.2
unnamed: R308.1, U303.3 (Rg)
unnamed: R308.2, U303.2 (Rg)
unnamed: R309.1, R318.1, U303.7
unnamed: R310.2, R311.1
unnamed: R314.1, U301.6 (-)
unnamed: R314.2, R317.1, U301.7
unnamed: R402.2, R403.1, U401.2 (-)
unnamed: R404.2, R405.1
unnamed: R405.2, R406.1, R407.1, R422.1
unnamed: R407.2, R411.2, R412.1, R423.2
unnamed: R408.1, U403.3 (Rg)
unnamed: R408.2, U403.2 (Rg)
unnamed: R409.1, R418.1, U403.7
unnamed: R410.2, R411.1
unnamed: R414.1, U401.6 (-)
unnamed: R414.2, R417.1, U401.7
unnamed: R502.2, R503.1, U501.2 (-)
unnamed: R504.2, R505.1
unnamed: R505.2, R506.1, R507.1, R522.1
unnamed: R507.2, R511.2, R512.1, R523.2
unnamed: R508.1, U503.3 (Rg)
unnamed: R508.2, U503.2 (Rg)
unnamed: R509.1, R518.1, U503.7
unnamed: R510.2, R511.1
unnamed: R514.1, U501.6 (-)
unnamed: R514.2, R517.1, U501.7
unnamed: R601.1, RV601.2
unnamed: R602.1, SW601.1
unnamed: R603.1, SW601.2
unnamed: R604.1, SW601.3
unnamed: R605.1, SW601.4
unnamed: R606.1, U603.8
unnamed: R607.1, RV602.2
unnamed: R608.1, U603.11
unnamed: R609.1, RV603.2
unnamed: R610.1, U603.3
unnamed: R611.1, RV604.3
unnamed: R612.1, U603.6
unnamed: R701.2, U702.19 (Q0)
unnamed: R702.2, U702.18 (Q1)
unnamed: R703.2, U702.17 (Q2)
unnamed: R704.2, U702.16 (Q3)
unnamed: R705.2, U702.15 (Q4)
unnamed: R706.1, U705.6
unnamed: R710.1, U705.4
unnamed: R712.1, U704.6
unnamed: R712.2, U706.1 (Anode)
unnamed: R801.1, RV801.2
unnamed: R801.2, R802.1, U801.2 (-)
unnamed: R803.1, R805.2, U801.5 (+)
unnamed: R905.2, R906.1, U905.3 (ADJ)
unnamed: R908.2, R909.1, U907.8 (SENSE/ADJ)
unnamed: U702.11 (Cp), U703.8
unnamed: U702.14 (Q5), U703.12, U704.1, U705.1, U705.3
unnamed: U202.6 (-), U203.4 (+)
unnamed: U202.7 (+), U203.1 (-)
unnamed: U302.6 (-), U303.4 (+)
unnamed: U302.7 (+), U303.1 (-)
unnamed: U402.6 (-), U403.4 (+)
unnamed: U402.7 (+), U403.1 (-)
unnamed: U502.6 (-), U503.4 (+)
unnamed: U502.7 (+), U503.1 (-)
unnamed: U601.1, U602.12 (~Q)
unnamed: U601.2, U601.4, U602.5 (Q)
unnamed: U601.3, U603.12
unnamed: U601.6, U603.13
unnamed: U601.8, U603.9
unnamed: U601.9, U602.4 (~Q)
unnamed: U601.10, U601.12, U602.13 (Q)
unnamed: U601.11, U603.10
unnamed: U603.1, U604.8
unnamed: U603.2, U604.11
unnamed: U603.4, U604.3
unnamed: U603.5, U604.6
unnamed: U604.1, U605.12 (~Q)
unnamed: U604.2, U604.4, U605.5 (Q)
unnamed: U604.9, U605.4 (~Q)
unnamed: U604.10, U604.12, U605.13 (Q)
unnamed: U701.8, U702.7 (D5), U703.1, U703.2
unnamed: U701.10, U701.11
unnamed: U701.6, U701.12
unnamed: U701.3, U701.13
unnamed: U703.10, U703.11
unnamed: U703.3, U703.13
unnamed: U801.6 (-), U801.7
