cnpem-emi/qds-cv-hw/(commit log)

2023-03-08 Include subcircuits and symbols to library and simulations of conditioning circuit
2023-03-16 Updated input resistors from isolated front-end circuit simulation model
2023-03-17 Create KiCad project
    [qds-cv.kicad_pcb, qds-cv.kicad_sch]
2023-03-17 Ignore KiCad backups
2023-03-17 Included project field name templates
    [qds-cv.kicad_sch]
2023-03-17 Define sheet hierarchy and title block
    [analog-front-end.kicad_sch, detection-validation.kicad_sch, power-supplies.kicad_sch, qds-cv.kicad_sch, quench-trigger.kicad_sch]
2023-03-17 Included design rules for LPKF and JLCPCB and 4-layer board stack-up
    [qds-cv.kicad_pcb]
2023-03-20 create symbol library for KiCad schematic
2023-03-20 new symbols, footprints and 3d models added to project's library
    [HFBR-1521Z.STEP, JCM30.STEP, RI-1515S.step]
2023-03-21 Analog front-end schematic created
    [analog-front-end.kicad_sch, qds-cv.kicad_sch]
2023-03-21 Power supplies schematic created
    [CUI_DEVICES_PJ-002AH.step, LT1965EMS8E_PBF.step, SMBJ15A.step, ZH242-CAP.STEP, ZH242.STEP, power-supplies.kicad_sch, qds-cv.kicad_sch, quench-trigger.kicad_sch]
2023-03-21 Comparator circuit included on the front-end sheet
    [analog-front-end.kicad_sch, qds-cv.kicad_sch]
2023-03-22 Included power supplies circuits and +5V-REF RC circuit in analog front-end
    [934CB_GD.STEP, 934CB_ID.STEP, analog-front-end.kicad_sch, power-supplies.kicad_sch, qds-cv.kicad_sch]
2023-03-23 Validation schematic created
    [detection-validation.kicad_sch, qds-cv.kicad_sch]
2023-03-24 specify components used in front-end, validation and power circuits, except resistors
    [analog-front-end.kicad_sch, detection-validation.kicad_sch, power-supplies.kicad_sch, qds-cv.kicad_sch]
2023-03-29 create schematic for trigger aggregation, indication and actuation circuits
    [analog-front-end.kicad_sch, qds-cv.kicad_sch, quench-trigger.kicad_sch]
2023-03-29 Created hierarchy connections, updates on analog-front-end and included 5V reference circuit
    [5v-reference.kicad_sch, analog-front-end.kicad_sch, detection-validation.kicad_sch, qds-cv.kicad_sch, quench-trigger.kicad_sch]
2023-03-30 update components specification
    [analog-front-end.kicad_sch, detection-validation.kicad_sch, qds-cv.kicad_sch, quench-trigger.kicad_sch]
2023-03-31 Update componentes fields and reference circuit
    [5v-reference.kicad_sch, analog-front-end.kicad_sch, detection-validation.kicad_sch, power-supplies.kicad_sch, qds-cv.kicad_sch, quench-trigger.kicad_sch]
2023-03-31 replace 4k7 resistors part number
    [analog-front-end.kicad_sch, qds-cv.kicad_sch, quench-trigger.kicad_sch]
2023-04-01 Fixed footprints 3D models orientation
    [3224X.stp, 5v-reference.kicad_sch, analog-front-end.kicad_sch, detection-validation.kicad_sch, qds-cv.kicad_sch, quench-trigger.kicad_sch]
2023-04-01 Update power supplies, symbols and footprint libs
    [5v-reference.kicad_sch, MSOP-12_MSE.STEP, analog-front-end.kicad_sch, detection-validation.kicad_sch, power-supplies.kicad_sch, qds-cv.kicad_sch, quench-trigger.kicad_sch]
2023-04-01 Grouped 74HC123 into two IC's and updated BNC connector 3D model
    [0731375003.STEP, analog-front-end.kicad_sch, detection-validation.kicad_sch, qds-cv.kicad_sch, quench-trigger.kicad_sch]
2023-04-04 Fix +5V power reference so it is connected to R-78E5 output
    [power-supplies.kicad_sch]
2023-04-10 Move schematic symbols and text fields for a better view
    [detection-validation.kicad_sch, quench-trigger.kicad_sch]
2023-04-11 Fix U705 supply voltage, add decoupling capacitor and remove unused parts - close #1 - close #2 - close #3
    [detection-validation.kicad_sch, qds-cv.kicad_sch, quench-trigger.kicad_sch]
2023-04-11 Fix isolated supplies from analog-front-end, include no-connection flags, move itens in root sheet for better view, redefine pin types to fix ERC
    [5v-reference.kicad_sch, analog-front-end.kicad_sch, detection-validation.kicad_sch, power-supplies.kicad_sch, qds-cv.kicad_sch, quench-trigger.kicad_sch]
2023-04-19 Include pdf file for schematics, remove pdf files from gitignore, delete template pdf file
2023-04-26 Several updates on schematic - close #5, close #6, close #7, close #8. - include test points - change relay supply to 15V and its series resistor to 180 ohm - replace AMC1200 VDD1 capacitor of 100nF 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
    [5v-reference.kicad_sch, analog-front-end.kicad_sch, detection-validation.kicad_sch, power-supplies.kicad_sch, qds-cv.kicad_sch, quench-trigger.kicad_sch]
2023-04-26 Start PCB design based on 1-channel version layout
    [qds-cv.kicad_pcb, qds-cv.kicad_sch]
2023-04-27 Preliminary placement of components from detection to validation stages
    [5v-reference.kicad_sch, JCM30.STEP, MSOP-12_MSE.STEP, detection-validation.kicad_sch, qds-cv.kicad_pcb, qds-cv.kicad_sch, quench-trigger.kicad_sch]
2023-05-03 Include resistors tied to +5V and GND in isolated front-end circuits
    [analog-front-end.kicad_sch, qds-cv.kicad_sch]
2023-05-04 Reposition of channels and connectors, place and route trigger and actuation circuit
    [BNC5-P-C-HN-ST-CA1.stp, DB-9-s8655mh0901bxx.STP, detection-validation.kicad_sch, qds-cv.kicad_pcb, qds-cv.kicad_sch, quench-trigger.kicad_sch]
2023-05-08 Replicate detection layout for all channels, place and route 5V-REF circuit
    [5v-reference.kicad_sch, detection-validation.kicad_sch, qds-cv.kicad_pcb, quench-trigger.kicad_sch]
2023-05-09 Create +14V, -14V, +5V copper zones
    [detection-validation.kicad_sch]
2023-05-10 Improve window comparator, +5V-REF and relay driver circuits close #19 close #20 close #22
    [5v-reference.kicad_sch, analog-front-end.kicad_sch, power-supplies.kicad_sch, qds-cv.kicad_sch, quench-trigger.kicad_sch]
2023-05-10 Apply several changes based on test results - replace validation time 4k7 resistor by a 8k2, close #21 - remove pull-up resistor from AMC1200 positive input - split voltage taps pull-up/down resistor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
    [analog-front-end.kicad_sch, detection-validation.kicad_sch, qds-cv.kicad_sch, quench-trigger.kicad_sch]
2023-05-12 Set board stack-up according to JLCPCB specifications
    Specifications were obtained in https://jlcpcb.com/impedance for the following requirements:
    - 4-layer PCB with 1.6 mm thickness
    - 1 oz outer copper weight
    - 0.5 oz inner copper weight
    - "No requirement" stackup
    - Outer layer copper thickness: 0.035 mm
    - Prepreg 7628
    - Thickness: 0.2104 mm
    - Dielectric constant: 4.6
    - Inner layer copper thickness: 0.0152 mm
    - Core:
    - Thickness: 1.065 mm
    - Dielectric constant: 4.6om
2023-05-12 Add stitching capacitors to isolated supply circuits
    [analog-front-end.kicad_sch, power-supplies.kicad_sch, qds-cv.kicad_sch, quench-trigger.kicad_sch]
2023-05-15 Route front-end voltage taps
2023-05-16 Place test-points, improve isolated circuit layout (channel D only)
    [5v-reference.kicad_sch, TEST-POINT-White-Keystone-5012.stp, ZH212.step, analog-front-end.kicad_sch, qds-cv.kicad_sch, quench-trigger.kicad_sch]
2023-05-16 Define JLCPCB manufacturing rules
    [gerber.drl]
2023-05-16 Increase DB-25 shield connection, place fiducials close #30
    [qds-cv.kicad_sch]
2023-05-17 Design silkscreen layers
2023-05-17 Place stitching vias on board edge, close #29
2023-05-18 Improve power supply heat sink, copper areas and footprints close #32 close #33 close #34 close #36
2023-05-18 Increase +12V input tracks to 2 mm close #35
2023-05-18 Move JCM3012 closer to power input
2023-05-22 Replace C211 capacitor with a 0805 model close #37
    [analog-front-end.kicad_sch, qds-cv.kicad_sch]
2023-05-22 Include fiducials on bottom layer close #39
    [qds-cv.kicad_sch]
2023-05-23 Improve U903 connection to +15V plane close #44
2023-05-23 Remove solder mask covering thermal pads close #47
2023-05-23 Include all 3D models in project's library close #45
    [CP_EIA-3528-21_Kemet-B.step, CP_EIA-6032-28_Kemet-C.step, C_0603_1608Metric.step, C_0805_2012Metric.step, C_1206_3216Metric.step, C_1812_4532Metric.step, C_Elec_6.3x7.7.step, Converter_DCDC_RECOM_R-78E-0.5_THT.step]
2023-05-23 Apply KiCAD cleanup tools
2023-05-23 Correct C934 polarization, rearrange JCM3012 Vin capacitors
    [power-supplies.kicad_sch]
2023-05-24 Include 3D model for Hammond enclosure
    [HAMMOND-1455T2202-body.stp, HAMMOND-1455T2202-end-panel.stp, HAMMOND-1455T2202-top-plate.stp, HAMMOND-1455T2202.stp]
2023-05-24 Move POF signal track to top, increase -15V dissipation plane on botton
2023-05-24 Improve reset and sw_trigger circuits - add RC filter for reset signal (R713, C706) - change values of sw-trigger pull-up/down resistors (R709, R711) and add capacitor (C707)
    [qds-cv.kicad_sch, quench-trigger.kicad_sch]
2023-05-26 Include information on silkscreen close #38
2023-05-29 Update component values on RST circuit, cleanup tracks
    [qds-cv.kicad_sch, quench-trigger.kicad_sch]
2023-05-29 Update schematic PDF, update readme
    [qds-cv.kicad_sch]
2023-05-29 Export gerbers
    [qds-cv-B_Cu.gbl, qds-cv-B_Mask.gbs, qds-cv-B_Paste.gbp, qds-cv-B_Silkscreen.gbo, qds-cv-Edge_Cuts.gm1, qds-cv-F_Cu.gtl, qds-cv-F_Mask.gts, qds-cv-F_Paste.gtp]
2023-07-25 Replace protection flip-flop with latch, update components description generate HTML BOM list.
    [5v-reference.kicad_sch, altium-bom-template-ENT-AIS-SEI-v2022.xlsx, analog-front-end.kicad_sch, detection-validation.kicad_sch, power-supplies.kicad_sch, qds-cv.kicad_sch, quench-trigger.kicad_sch]
2023-08-09 Create mechanical files for enclosure side panels
    [back-panel.dxf, front-panel.dxf, model.step, side-panels.kicad_pcb, side-panels.kicad_sch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]
2023-09-26 Update component properties
    [5v-reference.kicad_sch, detection-validation.kicad_sch, quench-trigger.kicad_sch]
2023-09-26 Replace tantalum capacitor symbols with polarized version close #51
    [5v-reference.kicad_sch]
2023-09-28 Include SPICE simulations for LTSPICE and TINA
    - Broken-wire detection circuit
    - Input overvoltage protection
    - Pertubation on external SW trigger interface
    - AMC1200 (IsoAmp) CMRR and noise analysis
    - BNC monitor noise
2024-02-28 Simulation for proposed scheme to fix broken wire detection
