cnpem-emi/qds-cv-hw/(notices)

Notices in the files:
pcb/cad/3dmodels/C_1206_3216Metric.step:
Copyright (C) 2017, kicad StepUp
This work is licensed under the [Creative Commons CC-BY-SA 4.0 License](https://creativecommons.org/licenses/by-sa/4.0/legalcode),
with the following exception:
To the extent that the creation of electronic designs that use 'Licensed Material' can be considered to be 'Adapted Material',
You are free to use the library data in your own projects without the obligation to share your project files under this or any other license agreement.
pcb/cad/3dmodels/D_SMA.step:
This program is free software: you can redistribute it and/or modify
it under the terms of the GNU General Public License as published by
the Free Software Foundation, either version 3 of the License, or
any later version.
itself might be covered by the GNU General Public License.
pcb/cad/3dmodels/R_0603_1608Metric.step:
Copyright (C) 2018, kicad StepUp
pcb/cad/3dmodels/SW_DIP_SPSTx04_Slide_6.7x11.72mm_W8.61mm_P2.54mm_LowProfile.step:
Copyright (C) 2018, Terje Io
This work is licensed under the Creative Commons CC-BY-SA 4.0 License with the following exception:
To the extent that the creation of electronic designs that use 'Licensed Material'
https://creativecommons.org/licenses/by-sa/4.0/legalcode
pcb/cad/3dmodels/DSUB-25_Female_Horizontal_P2.77x2.84mm_EdgePinOffset7.70mm_Housed_MountingHolesOffset9.12mm.step:
Copyright (C) 2020, kicad StepUp
pcb/cad/3dmodels/BNC5-P-C-HN-ST-CA1.stp:
author */ ('License CC BY-ND 4.0'),
